hwidvorakinfo/BeastH7_v1/BEASTH7_01.pdf

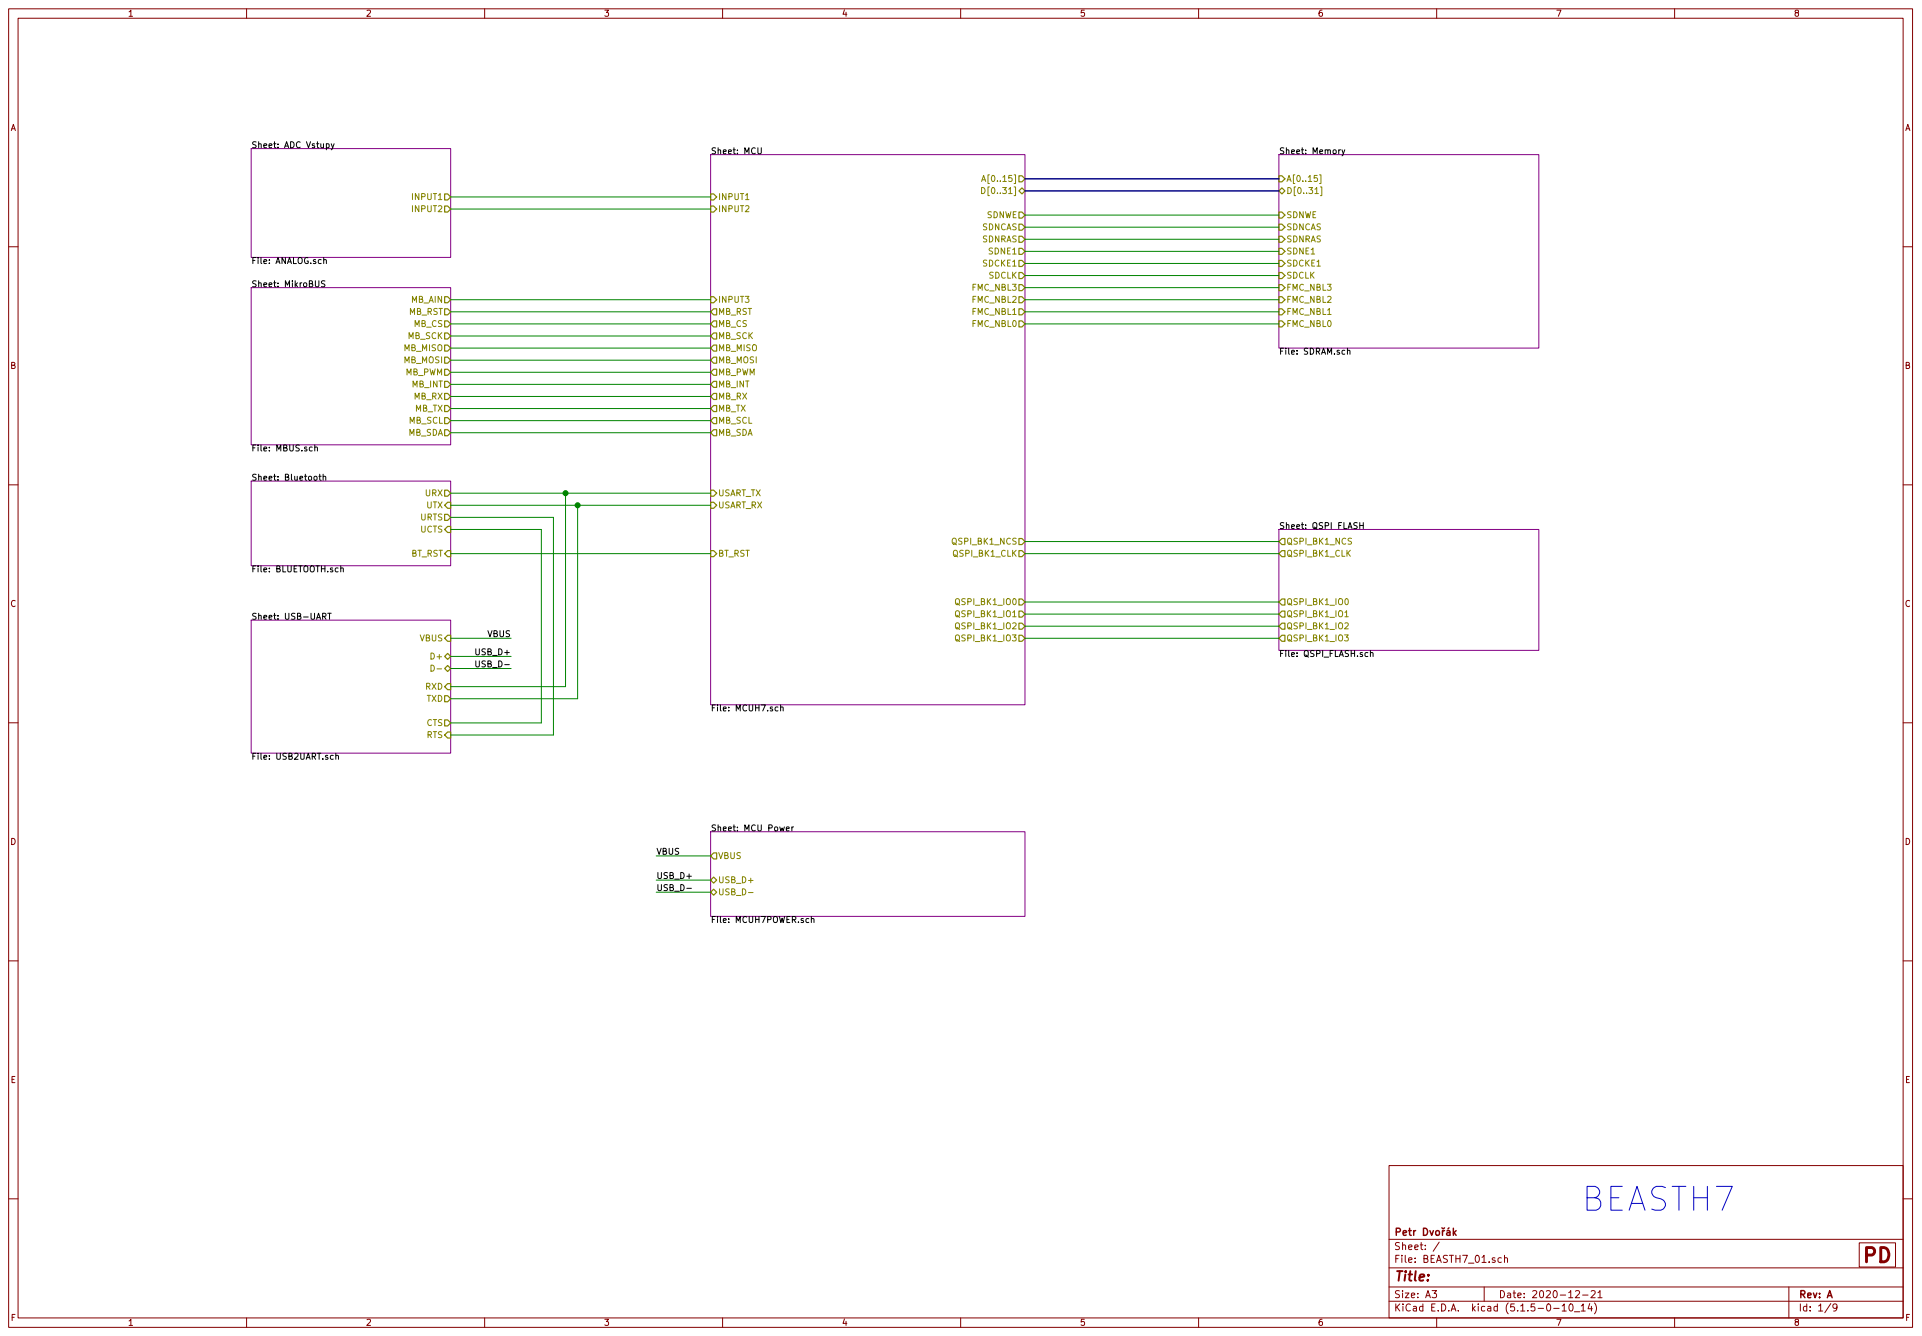
[picture p1: page 1]

Sheet: ADC Vstupy File: ANALOG.sch

Sheet: Memory File: SDRAM.sch A[0..15]

FMC_NBL3 FMC_NBL2 FMC_NBL1 FMC_NBL0 Sheet: MCU Power File: MCUH7POWER.sch USB_D+ USB_D- VBUS
INPUT3 USART_TX USART_RX MB_RST MB_CS MB_SCK MB_MISO MB_MOSI MB_PWM

File: BEASTH7_01.sch Sheet: / Petr Dvoák

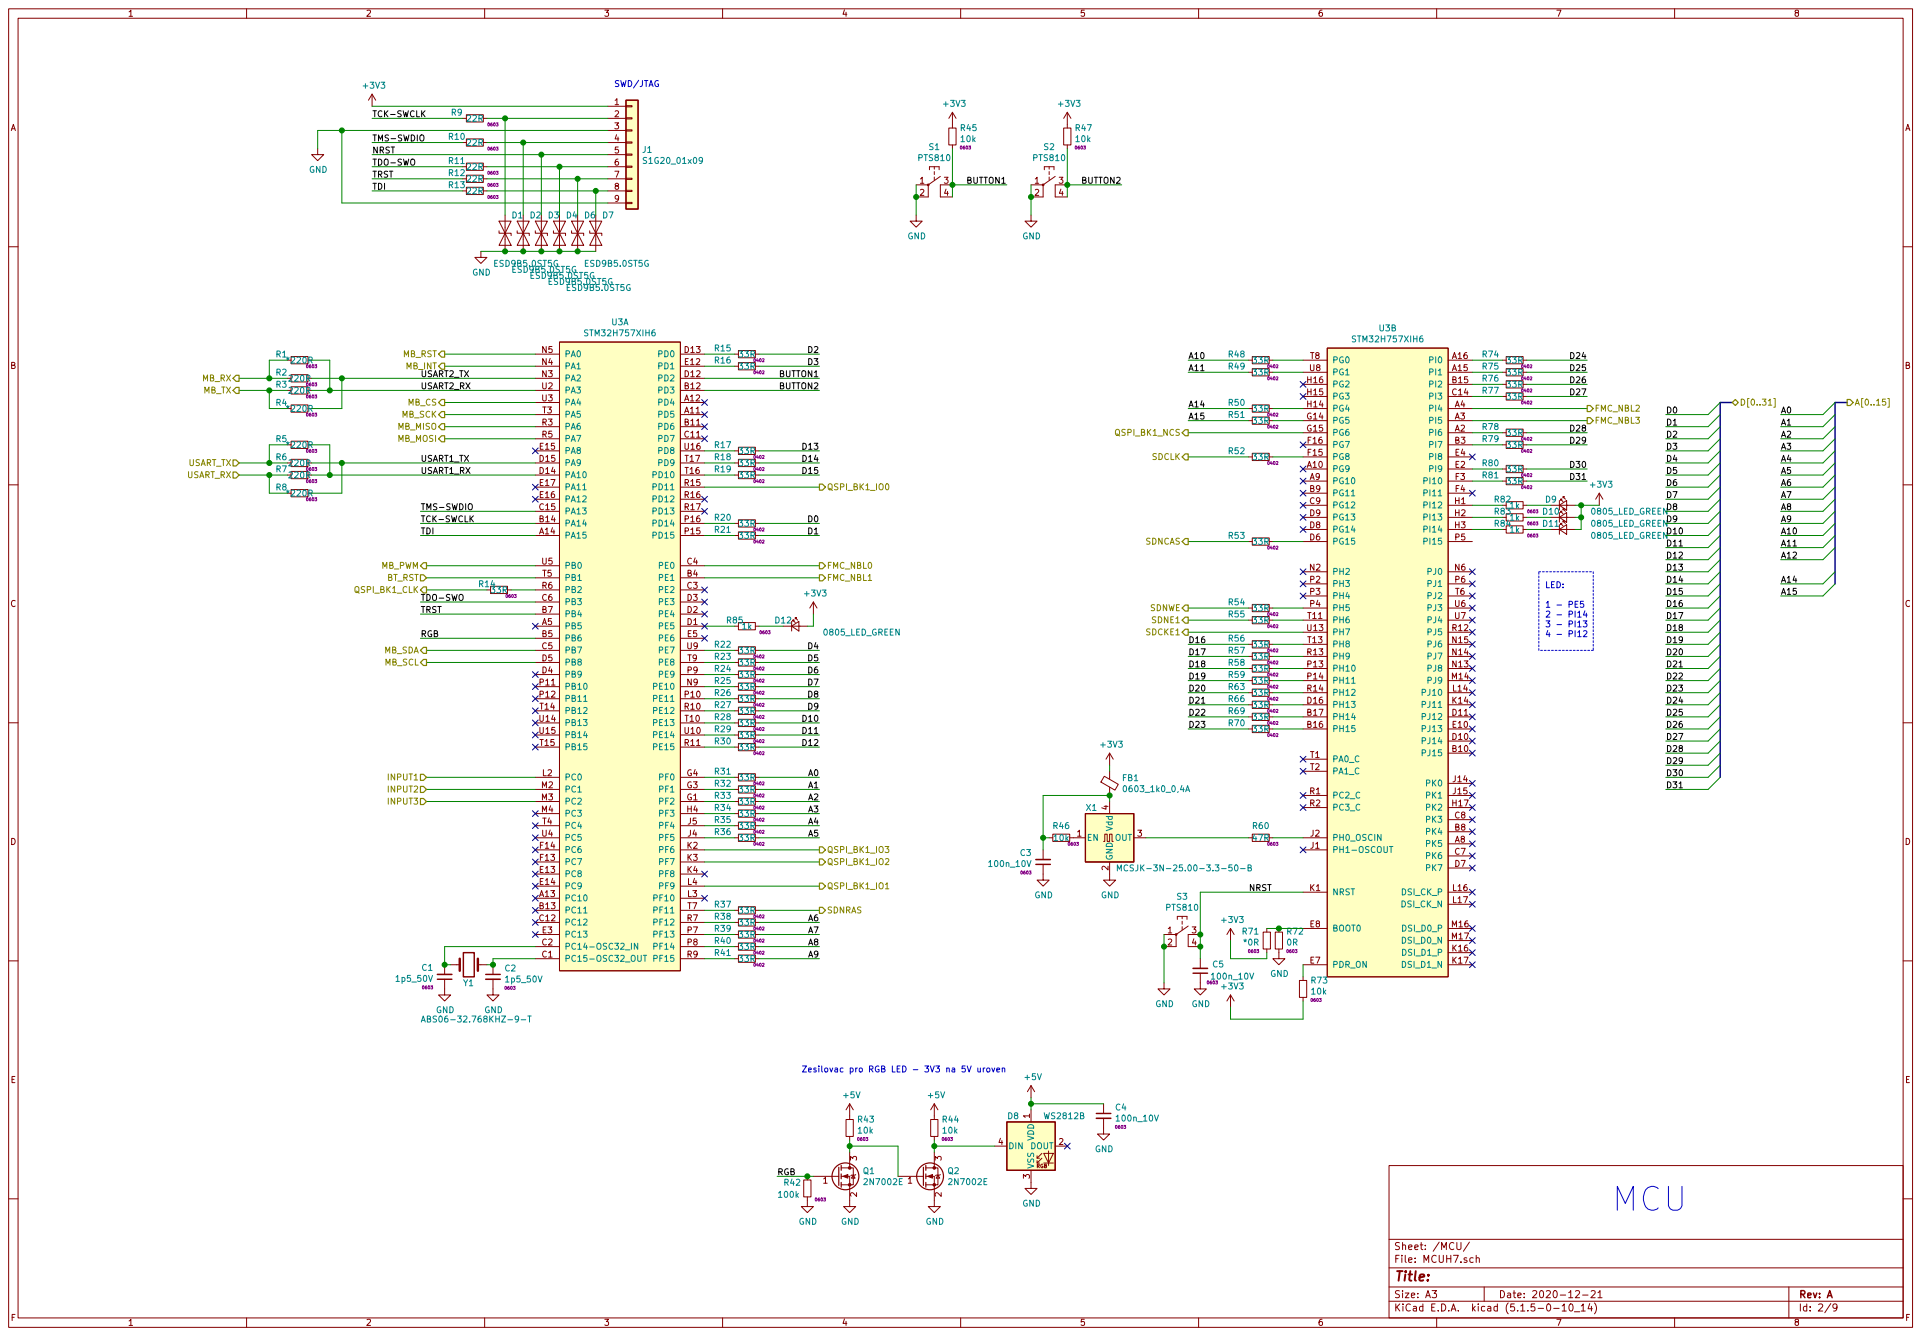
[picture p2: page 2]

6 | J1S1G20_01x09 GND

2 OUT 3 Vdd X1 4 MCSJK-3N-25.00-3.3-50-B GND

Zesilovac pro RGB LED - 3V3 na 5V uroven

Id: 2/9 Title: File: MCUH7.sch Sheet: /MCU/

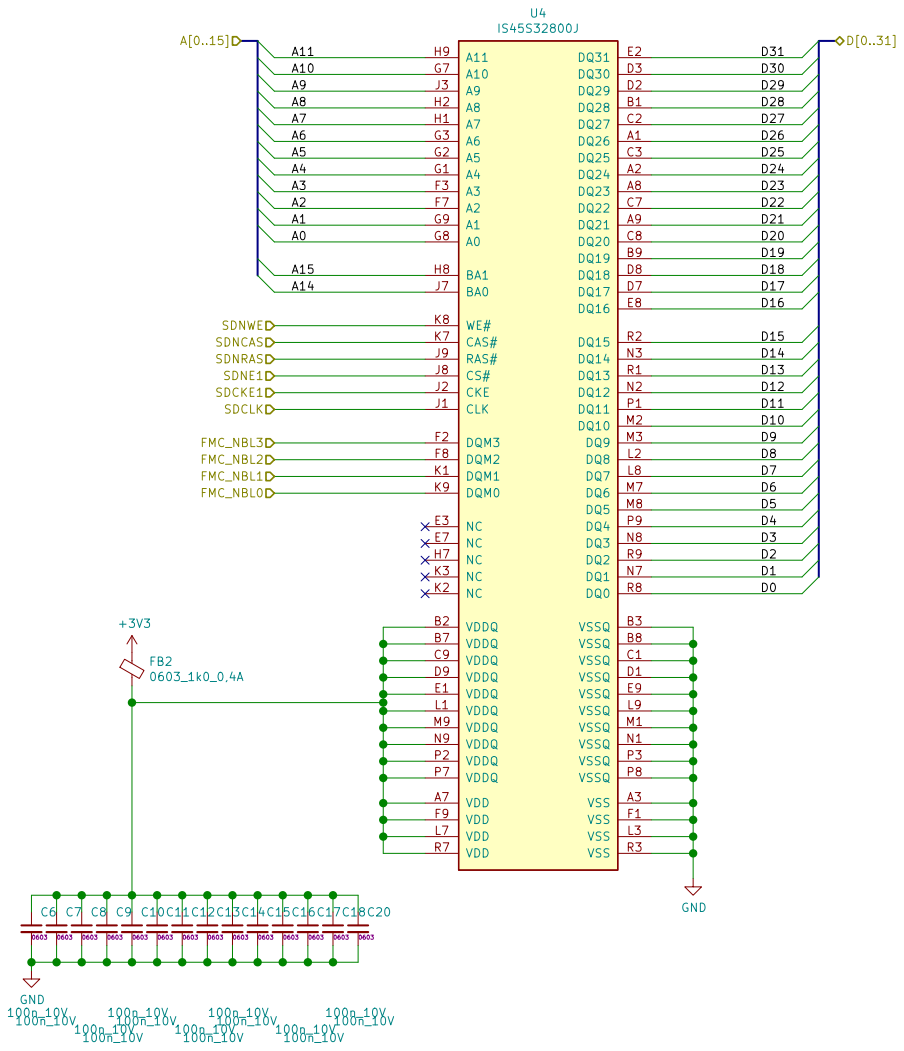
[picture p3: page 3]

Id: 3/9 Title: File: SDRAM.sch Sheet: /Memory/

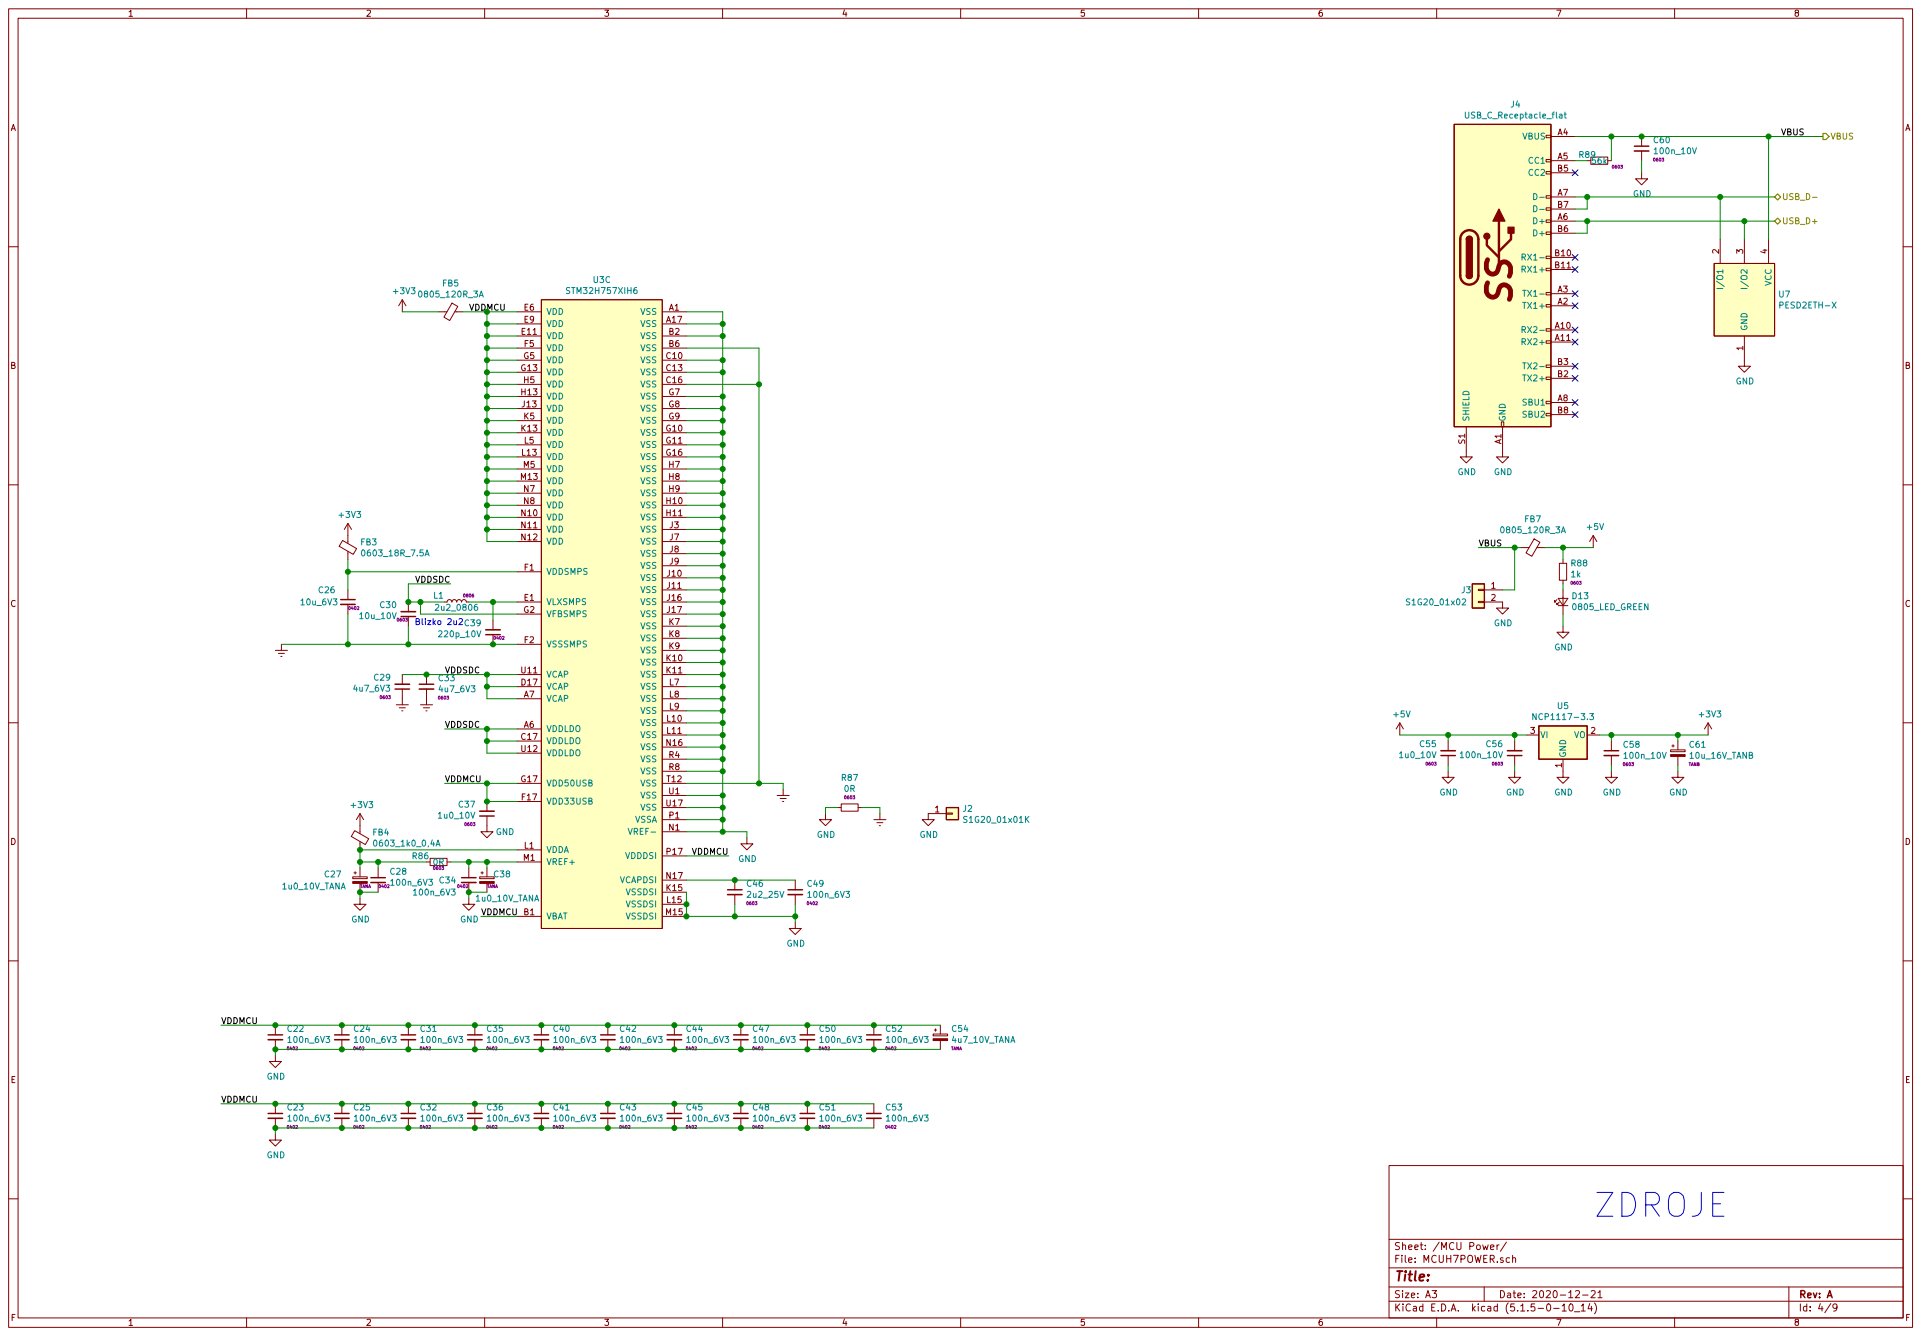
[picture p4: page 4]

Id: 4/9 Title: File: MCUH7POWER.sch Sheet: /MCU Power/

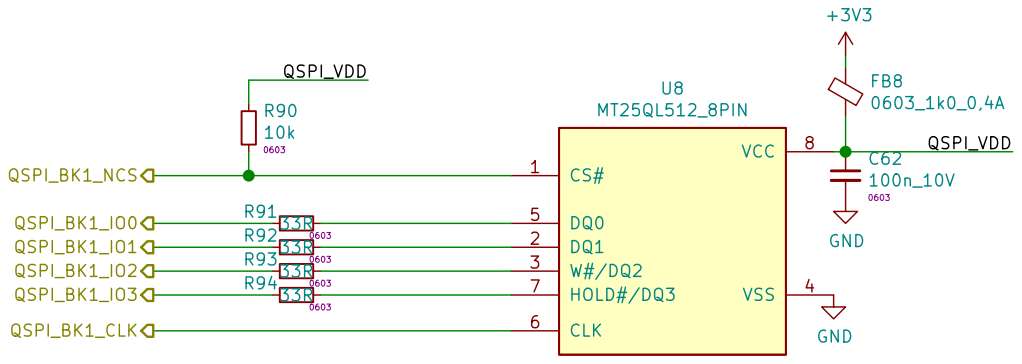
[picture p5: page 5]

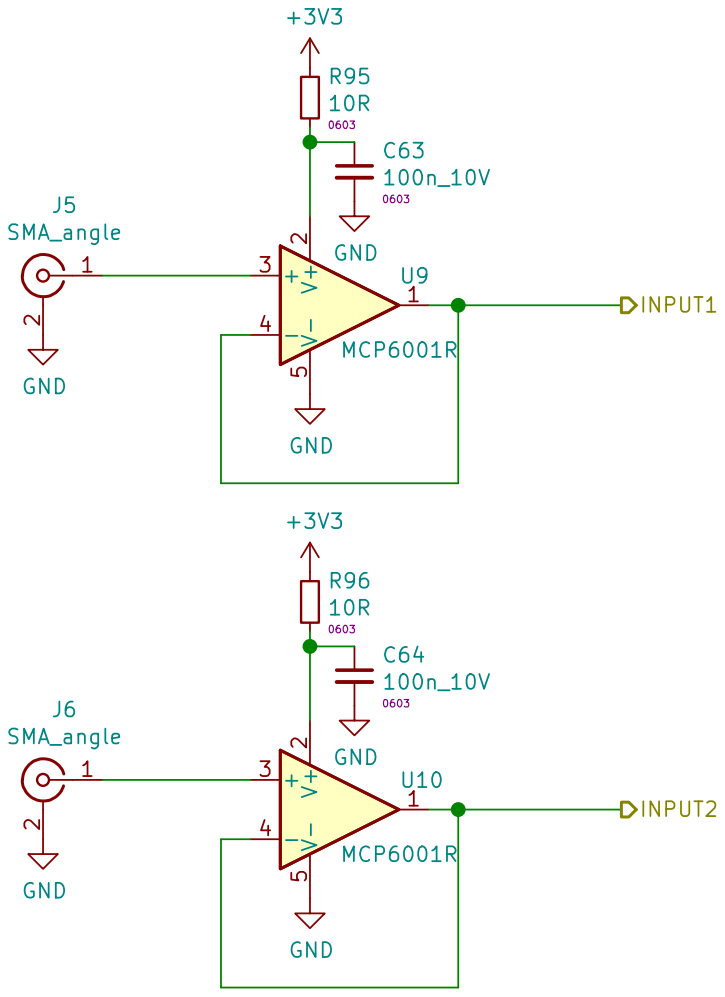
[picture p6: page 6]

Id: 6/9 Title: File: ANALOG.sch Sheet: /ADC Vstupy/ V+

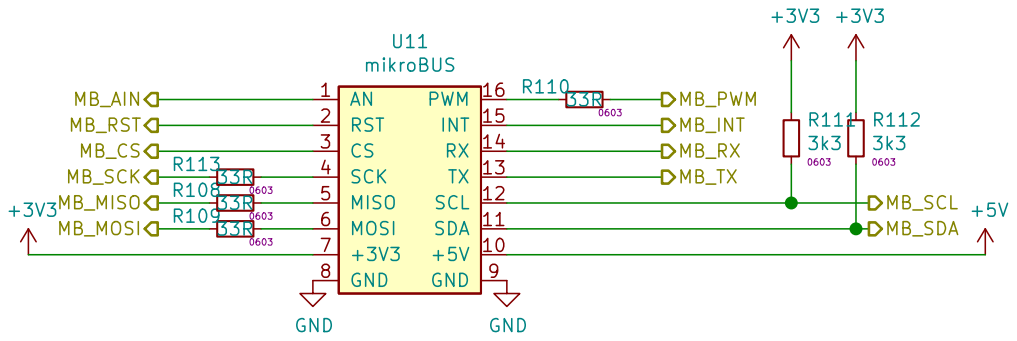
[picture p7: page 7]

Id: 7/9 Title: File: MBUS.sch Sheet: /MikroBUS/

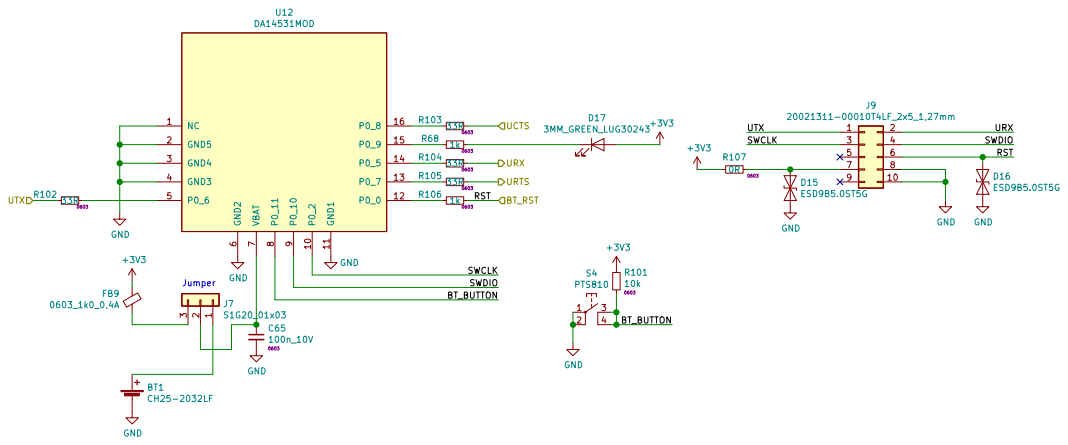
[picture p8: page 8]

Id: 8/9 Title: File: BLUETOOTH.sch Sheet: /Bluetooth/

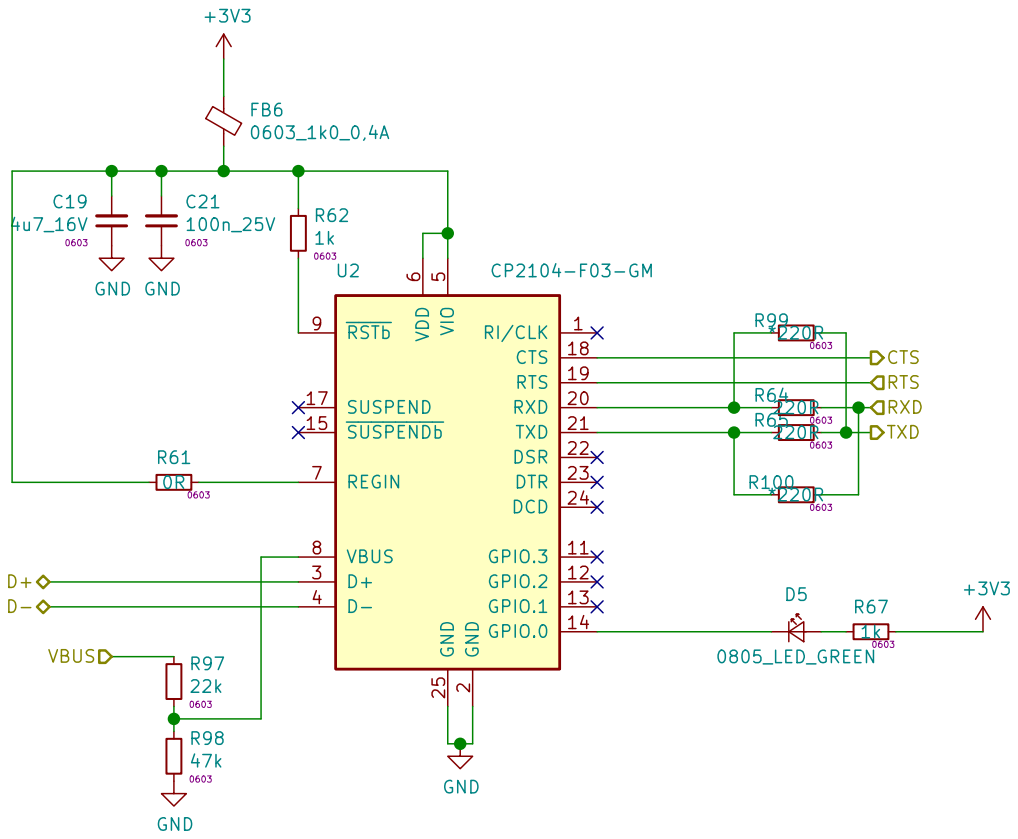
[picture p9: page 9]

6 REGIN 7 VBUS 8 RSTb 9 U2 CP2104-F03-GM

2 RXD 20 TXD 21 DSR 22 DTR 23 DCD 24 GND 25 D+ 3 D- 4 VIO

Id: 9/9 Title: File: USB2UART.sch Sheet: /USB-UART/ GND
