hwidvorakinfo/BeastH7_v1/BEASTH7_01.kicad_pcb

## KiCad design BEASTH7_01.kicad_pcb (2021-05-04)

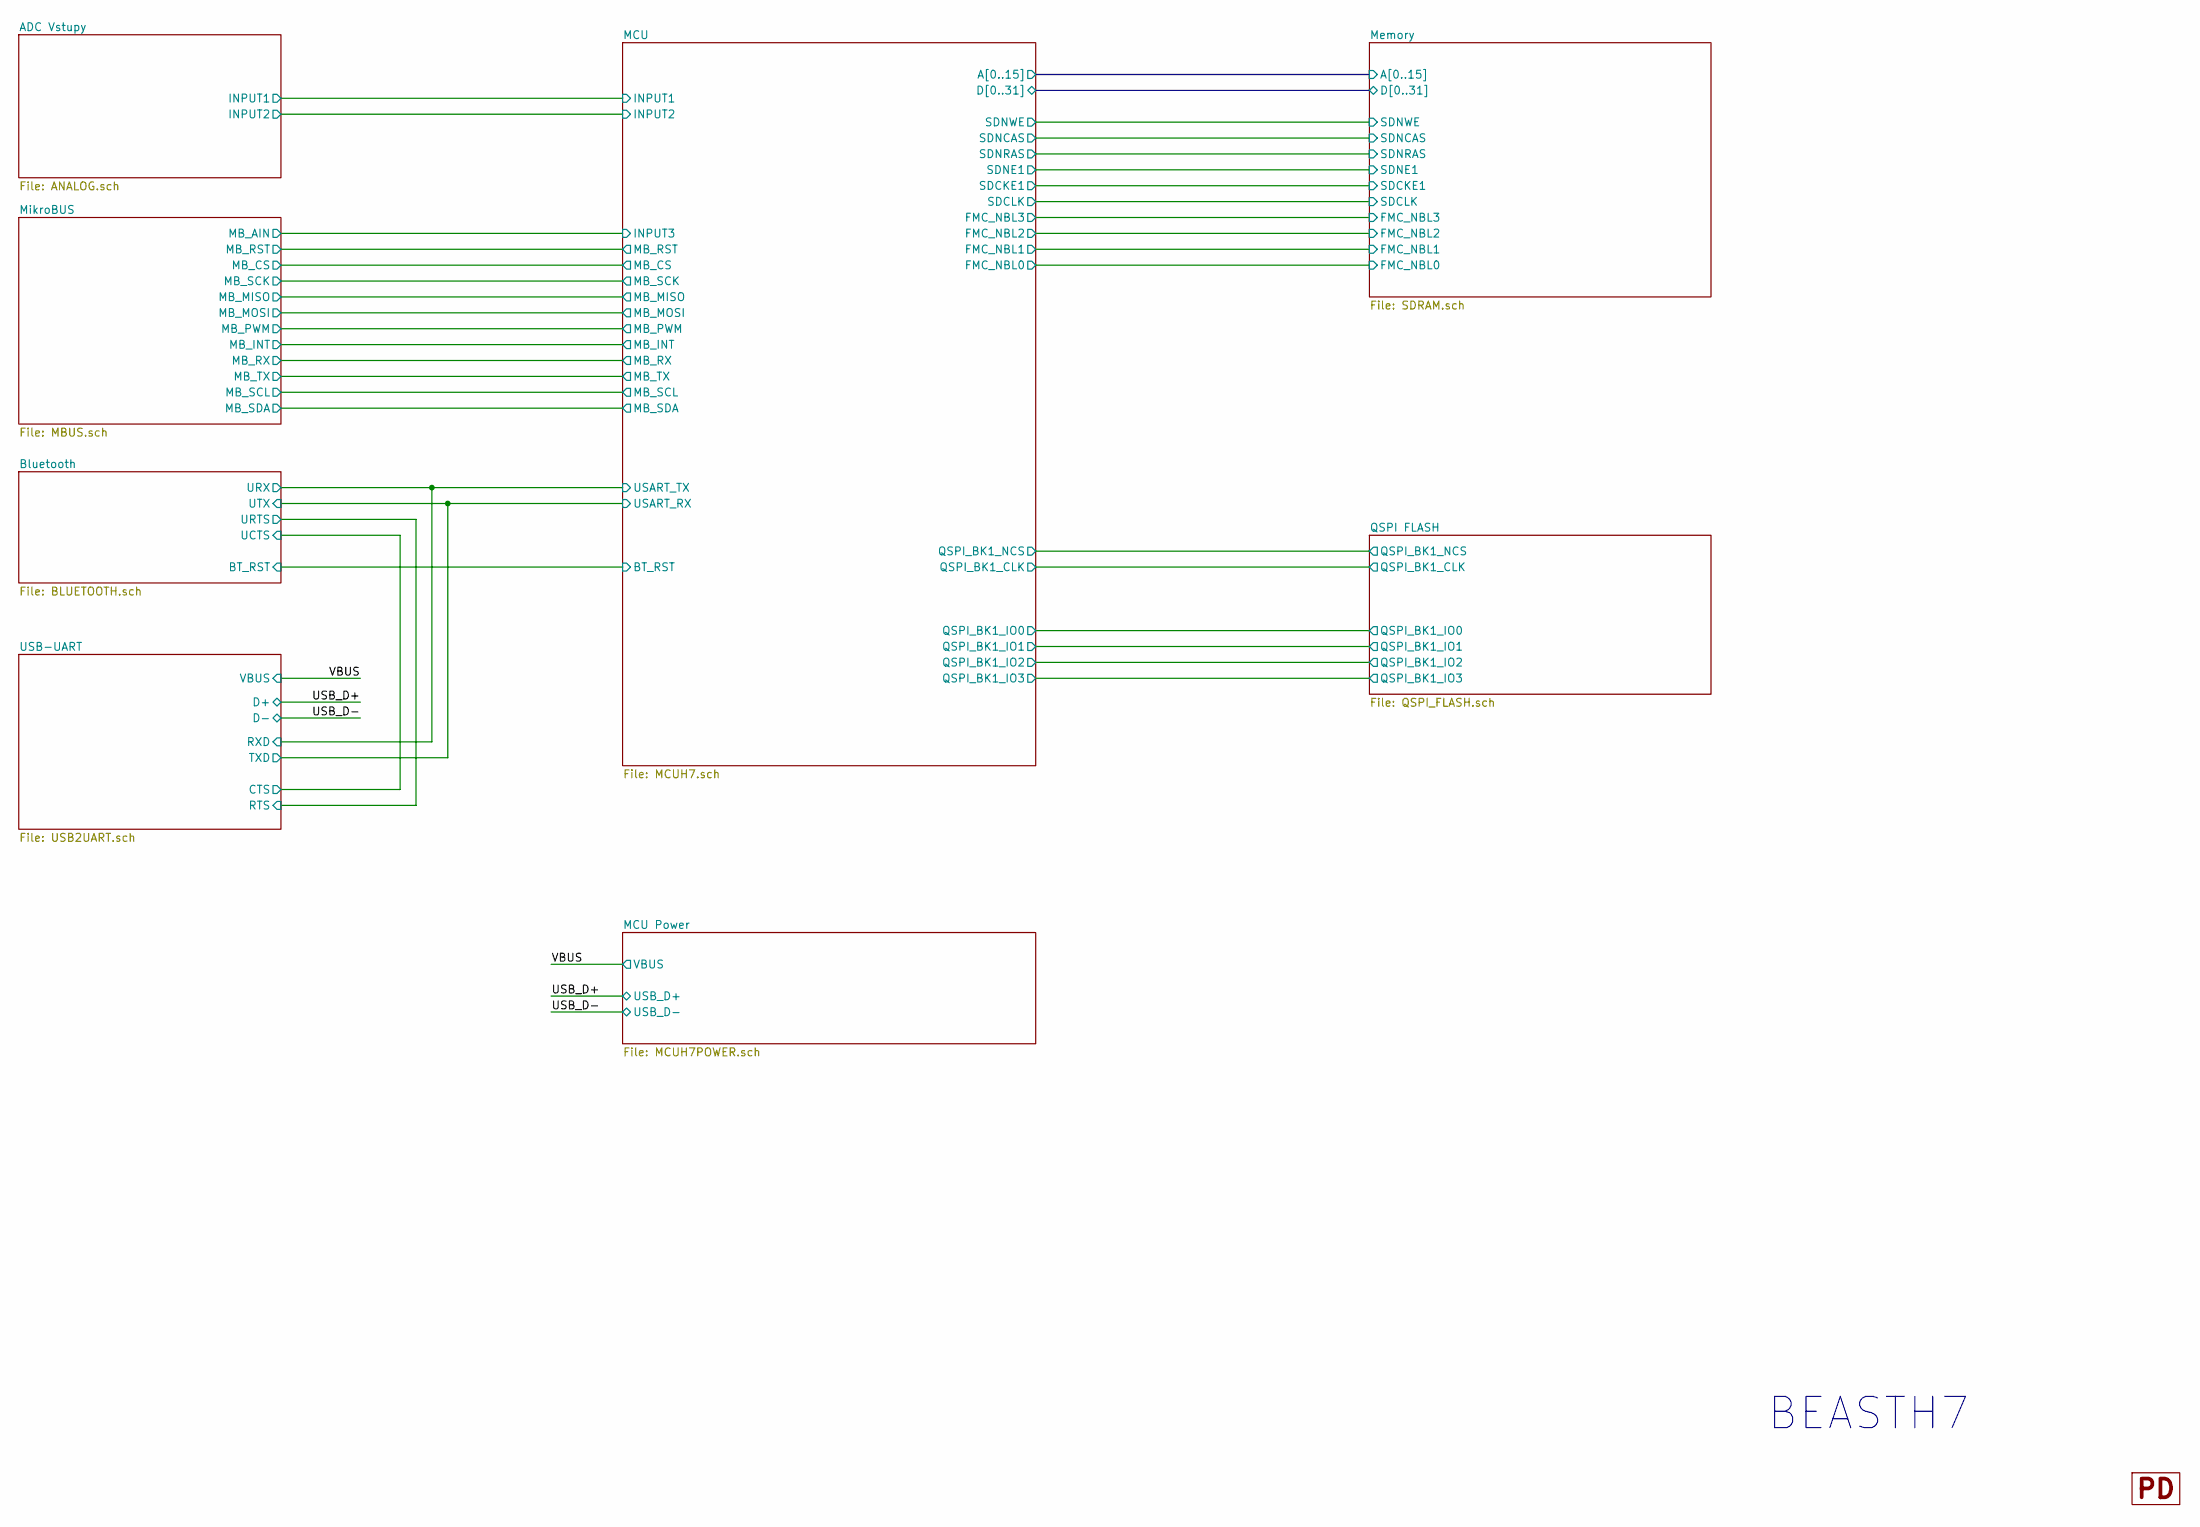
[picture p10: schematic BEASTH7_01.sch]

Parts:
U1: LOGO_IDVORAK; logo_idvorak_silk_top_5mm

Notes on the sheet:
BEASTH7

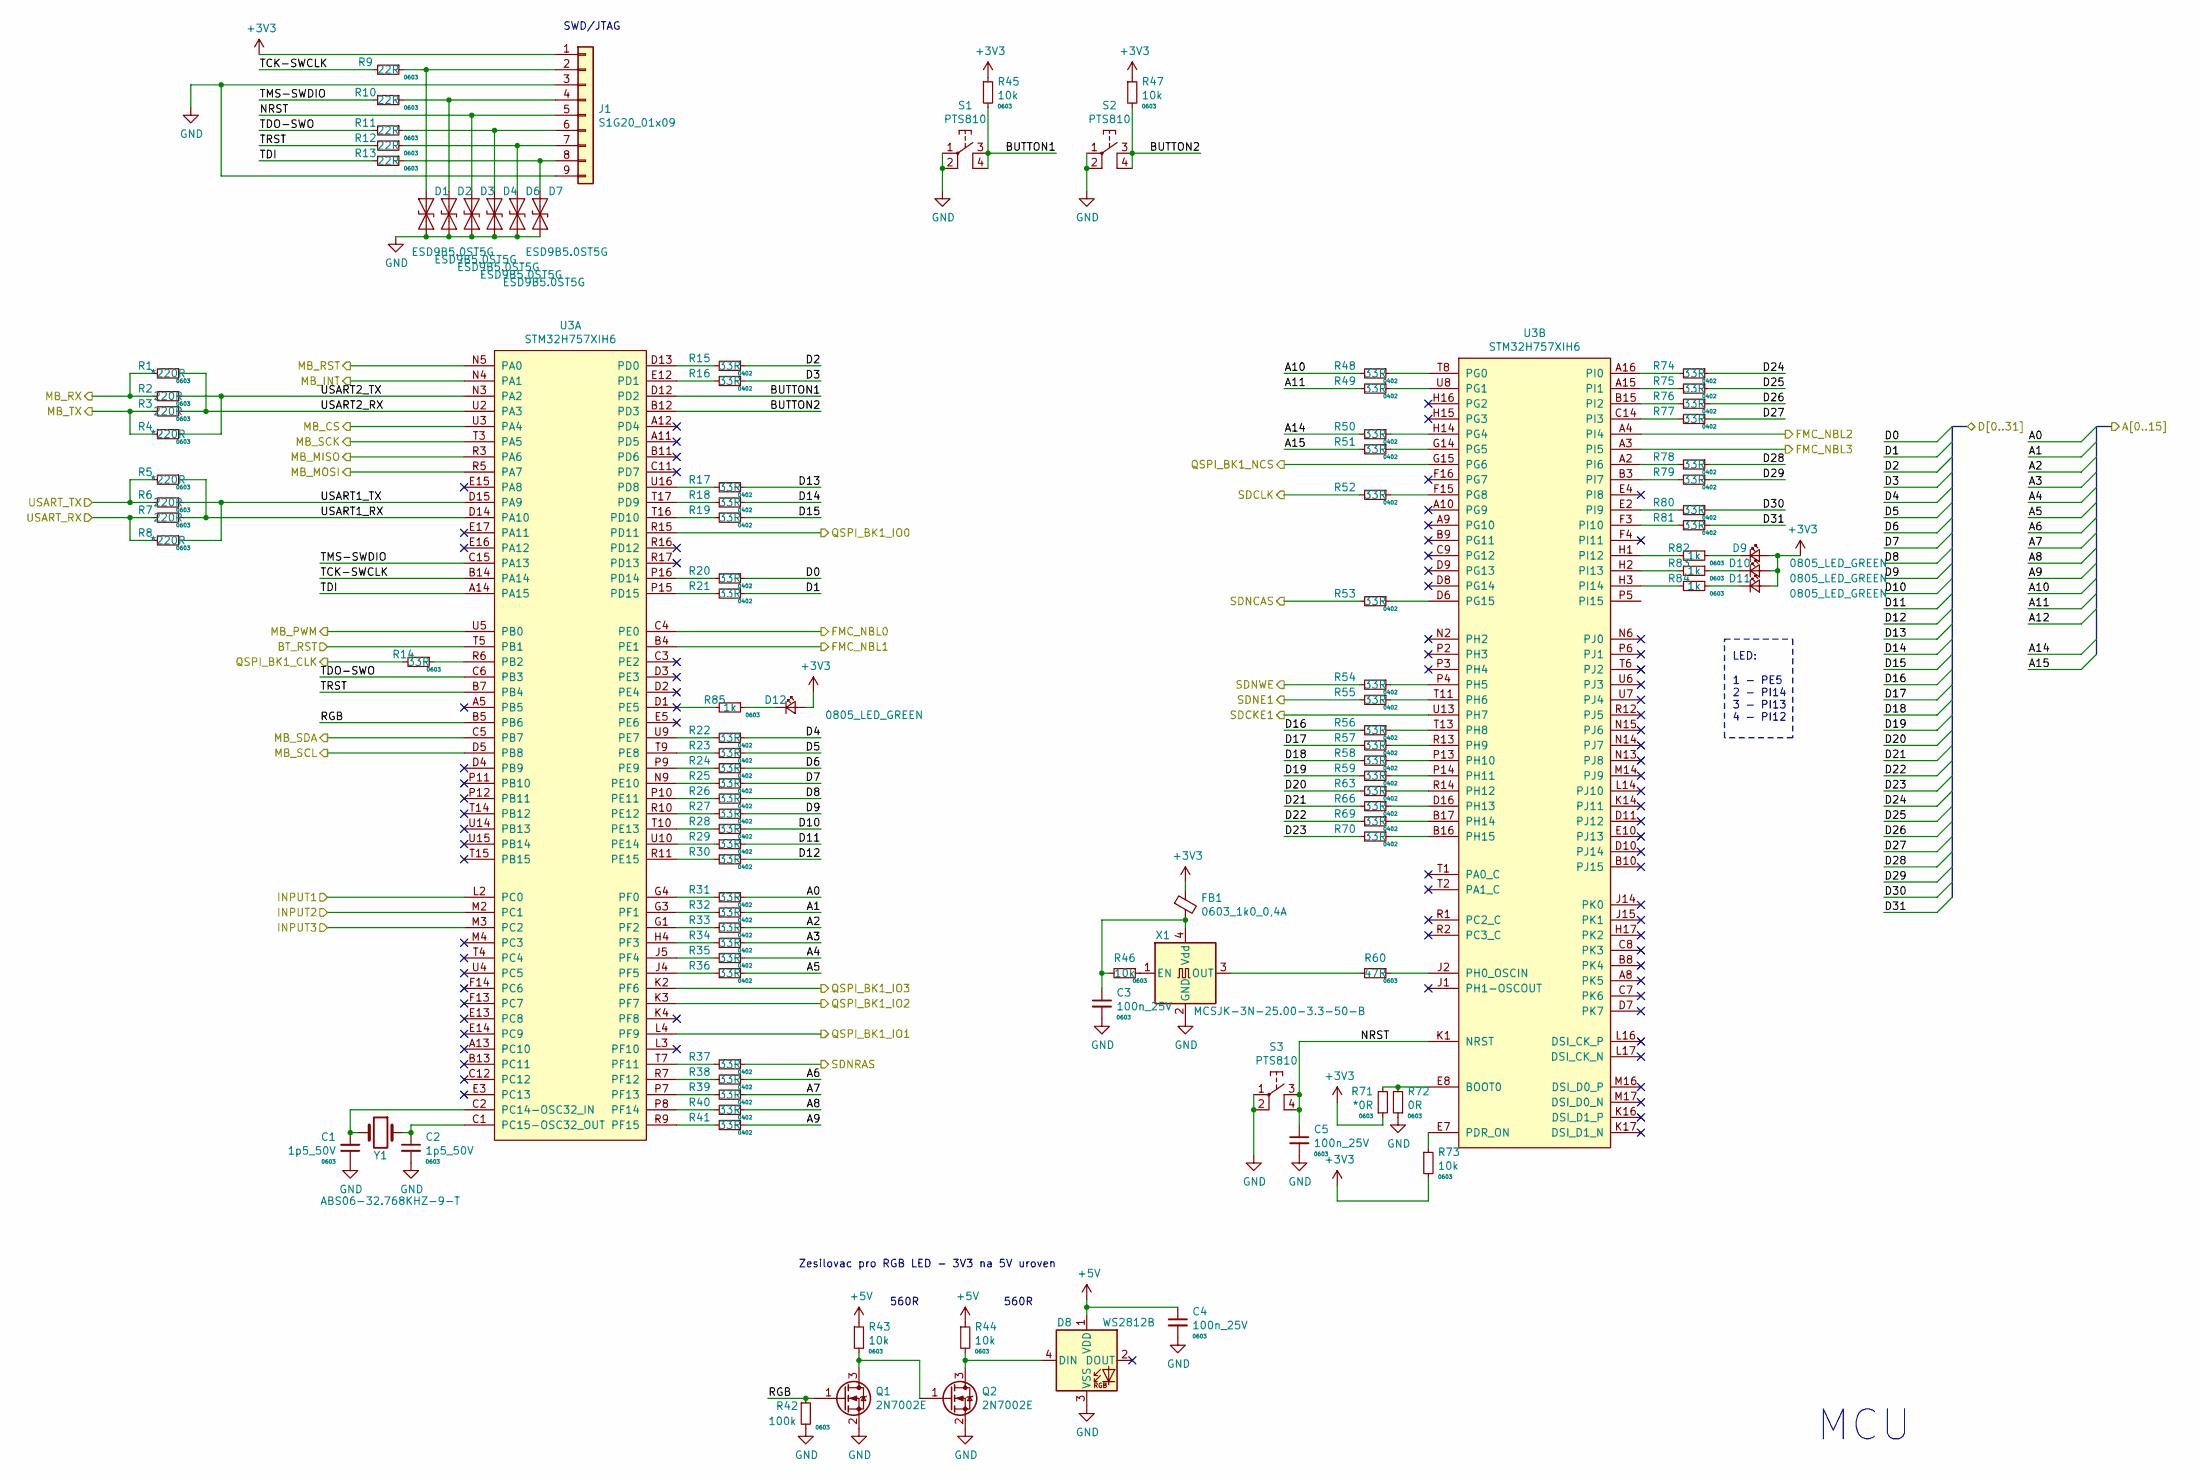
[picture p11: schematic MCUH7.sch]

Parts:
C1, C2: 1p5_50V; C_0603_1608Metric
C3, C4, C5: 100n_25V; C_0603_1608Metric
D1, D2, D3, D4, D6, D7: ESD9B5.0ST5G; D_0402_1005Metric
D8: WS2812B; WS2812B_PLCC4_5.0x5.0mm_P3.2mm
D9, D10, D11, D12: 0805_LED_GREEN; D_0805_2012Metric
FB1: 0603_1k0_0,4A; R_0603_1608Metric
J1: S1G20_01x09; PinHeader_1x09_P2.54mm_Vertical
Q1, Q2: 2N7002E; SOT-23
R1, R4, R5, R8: *220R; R_0603_1608Metric
R2, R3, R6, R7: 220R; R_0603_1608Metric
R9, R10, R11, R12, R13: 22R; R_0603_1608Metric
R14: 33R; R_0603_1608Metric
R15, R16, R17, R18, R19, R20, R21, R22, R23, R24, R25, R26, R27, R28, R29, R30, R31, R32, R33, R34, R35, R36, R37, R38, R39, R40, R41, R48, R49, R50, R51, R52, R53, R54, R55, R56, R57, R58, R59, R63, R66, R69, R70, R74, R75, R76, R77, R78, R79, R80, R81: 33R; R_0402_1005Metric
R42: 100k; R_0603_1608Metric
R43, R44, R45, R46, R47, R73: 10k; R_0603_1608Metric
R60: 47R; R_0603_1608Metric
R71: *0R; R_0603_1608Metric
R72: 0R; R_0603_1608Metric
R82, R83, R84, R85: 1k; R_0603_1608Metric
S1, S2, S3: PTS810; MIKROSPINAC_PTS810
U3: STM32H757XIH6; TFBGA-265_14x14mm_Layout17x17_P0.8mm
X1: MCSJK-3N-25.00-3.3-50-B; Oscillator_SMD_Abracon_ASE-4Pin_3.2x2.5mm
Y1: ABS06-32.768KHZ-9-T; Crystal_SMD_2012-2Pin_2.0x1.2mm_HandSoldering

Connections:
+3V3: D9.2 (A), D10.2 (A), D11.2 (A), D12.2 (A), FB1.1, J1.1, R45.1, R47.1, R71.1, R73.2; also elsewhere on the board
+5V: C4.1, D8.1 (VDD), R43.1, R44.1; also elsewhere on the board
/ADC Vstupy/INPUT1: U3.L2 (PC0); also elsewhere on the board
/ADC Vstupy/INPUT2: U3.M2 (PC1); also elsewhere on the board
/Bluetooth/BT_RST: U3.T5 (PB1); also elsewhere on the board
/MCU/A0: R31.1; also elsewhere on the board
/MCU/A1: R32.1; also elsewhere on the board
/MCU/A2: R33.1; also elsewhere on the board
/MCU/A3: R34.1; also elsewhere on the board
/MCU/A4: R35.1; also elsewhere on the board
/MCU/A5: R36.1; also elsewhere on the board
/MCU/A6: R38.1; also elsewhere on the board
/MCU/A7: R39.1; also elsewhere on the board
/MCU/A8: R40.1; also elsewhere on the board
/MCU/A9: R41.1; also elsewhere on the board
/MCU/A10: R48.2; also elsewhere on the board
/MCU/A11: R49.2; also elsewhere on the board
/MCU/A14: R50.2; also elsewhere on the board
/MCU/A15: R51.2; also elsewhere on the board
/MCU/BUTTON1: R45.2, S1.3, S1.4, U3.D12 (PD2)
/MCU/BUTTON2: R47.2, S2.3, S2.4, U3.B12 (PD3)
/MCU/D0: R20.1; also elsewhere on the board
/MCU/D1: R21.1; also elsewhere on the board
/MCU/D2: R15.1; also elsewhere on the board
/MCU/D3: R16.1; also elsewhere on the board
/MCU/D4: R22.1; also elsewhere on the board
/MCU/D5: R23.1; also elsewhere on the board
/MCU/D6: R24.1; also elsewhere on the board
/MCU/D7: R25.1; also elsewhere on the board
/MCU/D8: R26.1; also elsewhere on the board
/MCU/D9: R27.1; also elsewhere on the board
/MCU/D10: R28.1; also elsewhere on the board
/MCU/D11: R29.1; also elsewhere on the board
/MCU/D12: R30.1; also elsewhere on the board
/MCU/D13: R17.1; also elsewhere on the board
/MCU/D14: R18.1; also elsewhere on the board
/MCU/D15: R19.1; also elsewhere on the board
/MCU/D16: R56.2; also elsewhere on the board
/MCU/D17: R57.2; also elsewhere on the board
/MCU/D18: R58.2; also elsewhere on the board
/MCU/D19: R59.2; also elsewhere on the board
/MCU/D20: R63.2; also elsewhere on the board
/MCU/D21: R66.2; also elsewhere on the board
/MCU/D22: R69.2; also elsewhere on the board
/MCU/D23: R70.2; also elsewhere on the board
/MCU/D24: R74.1; also elsewhere on the board
/MCU/D25: R75.1; also elsewhere on the board
/MCU/D26: R76.1; also elsewhere on the board
/MCU/D27: R77.1; also elsewhere on the board
/MCU/D28: R78.1; also elsewhere on the board
/MCU/D29: R79.1; also elsewhere on the board
/MCU/D30: R80.1; also elsewhere on the board
/MCU/D31: R81.1; also elsewhere on the board
/MCU/FMC_NBL0: U3.C4 (PE0); also elsewhere on the board
/MCU/FMC_NBL1: U3.B4 (PE1); also elsewhere on the board
/MCU/FMC_NBL2: U3.A4 (PI4); also elsewhere on the board
/MCU/FMC_NBL3: U3.A3 (PI5); also elsewhere on the board
/MCU/INPUT3: U3.M3 (PC2); also elsewhere on the board
/MCU/MB_CS: U3.U3 (PA4); also elsewhere on the board
/MCU/MB_INT: U3.N4 (PA1); also elsewhere on the board
/MCU/MB_MISO: U3.R3 (PA6); also elsewhere on the board
/MCU/MB_MOSI: U3.R5 (PA7); also elsewhere on the board
/MCU/MB_PWM: U3.U5 (PB0); also elsewhere on the board
/MCU/MB_RST: U3.N5 (PA0); also elsewhere on the board
/MCU/MB_RX: R1.2, R2.2; also elsewhere on the board
/MCU/MB_SCK: U3.T3 (PA5); also elsewhere on the board
/MCU/MB_SCL: U3.D5 (PB8); also elsewhere on the board
/MCU/MB_SDA: U3.C5 (PB7); also elsewhere on the board
/MCU/MB_TX: R3.2, R4.2; also elsewhere on the board
/MCU/NRST: C5.1, D3.1 (A1), J1.5, S3.3, S3.4, U3.K1 (NRST)
/MCU/QSPI_BK1_CLK: R14.2; also elsewhere on the board
/MCU/QSPI_BK1_IO0: U3.R15 (PD11); also elsewhere on the board
/MCU/QSPI_BK1_IO1: U3.L4 (PF9); also elsewhere on the board
/MCU/QSPI_BK1_IO2: U3.K3 (PF7); also elsewhere on the board
/MCU/QSPI_BK1_IO3: U3.K2 (PF6); also elsewhere on the board
/MCU/QSPI_BK1_NCS: U3.G15 (PG6); also elsewhere on the board
/MCU/RGB: Q1.1 (G), R42.1, U3.B5 (PB6)
/MCU/SDCKE1: U3.U13 (PH7); also elsewhere on the board
/MCU/SDCLK: R52.2; also elsewhere on the board
/MCU/SDNCAS: R53.2; also elsewhere on the board
/MCU/SDNE1: R55.2; also elsewhere on the board
/MCU/SDNRAS: R37.1; also elsewhere on the board
/MCU/SDNWE: R54.2; also elsewhere on the board
/MCU/TCK-SWCLK: R9.2, U3.B14 (PA14)
/MCU/TDI: R13.2, U3.A14 (PA15)
/MCU/TDO-SWO: R11.2, U3.C6 (PB3)
/MCU/TMS-SWDIO: R10.2, U3.C15 (PA13)
/MCU/TRST: R12.2, U3.B7 (PB4)
/MCU/USART1_RX: R5.1, R7.1, U3.D14 (PA10)
/MCU/USART1_TX: R6.1, R8.1, U3.D15 (PA9)
/MCU/USART2_RX: R1.1, R3.1, U3.U2 (PA3)
/MCU/USART2_TX: R2.1, R4.1, U3.N3 (PA2)
/USB-UART/RXD: R5.2, R6.2; also elsewhere on the board
/USB-UART/TXD: R7.2, R8.2; also elsewhere on the board
GND: C1.1, C2.2, C3.2, C4.2, C5.2, D1.2 (A2), D2.2 (A2), D3.2 (A2), D4.2 (A2), D6.2 (A2), D7.2 (A2), D8.3 (VSS), J1.3, J1.9, Q1.2 (S), Q2.2 (S), R42.2, R72.1, S1.1, S1.2, S2.1, S2.2, S3.1, S3.2, X1.2 (GND); also elsewhere on the board
unnamed: C1.2, U3.C2 (PC14-OSC32_IN), Y1.2
unnamed: C2.1, U3.C1 (PC15-OSC32_OUT), Y1.1
unnamed: C3.1, FB1.2, R46.2, X1.4 (Vdd)
unnamed: D1.1 (A1), J1.2, R9.1
unnamed: D2.1 (A1), J1.4, R10.1
unnamed: D4.1 (A1), J1.6, R11.1
unnamed: D6.1 (A1), J1.7, R12.1
unnamed: D7.1 (A1), J1.8, R13.1
unnamed: D8.4 (DIN), Q2.3 (D), R44.2
unnamed: D9.1 (K), R82.1
unnamed: D10.1 (K), R83.1
unnamed: D11.1 (K), R84.1
unnamed: D12.1 (K), R85.1
unnamed: Q1.3 (D), Q2.1 (G), R43.2
unnamed: R14.1, U3.R6 (PB2)
unnamed: R15.2, U3.D13 (PD0)
unnamed: R16.2, U3.E12 (PD1)
unnamed: R17.2, U3.U16 (PD8)
unnamed: R18.2, U3.T17 (PD9)
unnamed: R19.2, U3.T16 (PD10)
unnamed: R20.2, U3.P16 (PD14)
unnamed: R21.2, U3.P15 (PD15)
unnamed: R22.2, U3.U9 (PE7)
unnamed: R23.2, U3.T9 (PE8)
unnamed: R24.2, U3.P9 (PE9)
unnamed: R25.2, U3.N9 (PE10)
unnamed: R26.2, U3.P10 (PE11)
unnamed: R27.2, U3.R10 (PE12)
unnamed: R28.2, U3.T10 (PE13)
unnamed: R29.2, U3.U10 (PE14)
unnamed: R30.2, U3.R11 (PE15)
unnamed: R31.2, U3.G4 (PF0)
unnamed: R32.2, U3.G3 (PF1)
unnamed: R33.2, U3.G1 (PF2)
unnamed: R34.2, U3.H4 (PF3)
unnamed: R35.2, U3.J5 (PF4)
unnamed: R36.2, U3.J4 (PF5)
unnamed: R37.2, U3.T7 (PF11)
unnamed: R38.2, U3.R7 (PF12)
unnamed: R39.2, U3.P7 (PF13)
unnamed: R40.2, U3.P8 (PF14)
unnamed: R41.2, U3.R9 (PF15)
unnamed: R46.1, X1.1 (EN)
unnamed: R48.1, U3.T8 (PG0)
unnamed: R49.1, U3.U8 (PG1)
unnamed: R50.1, U3.H14 (PG4)
unnamed: R51.1, U3.G14 (PG5)
unnamed: R52.1, U3.F15 (PG8)
unnamed: R53.1, U3.D6 (PG15)
unnamed: R54.1, U3.P4 (PH5)
unnamed: R55.1, U3.T11 (PH6)
unnamed: R56.1, U3.T13 (PH8)
unnamed: R57.1, U3.R13 (PH9)
unnamed: R58.1, U3.P13 (PH10)
unnamed: R59.1, U3.P14 (PH11)
unnamed: R60.1, U3.J2 (PH0_OSCIN)
unnamed: R60.2, X1.3 (OUT)
unnamed: R63.1, U3.R14 (PH12)
unnamed: R66.1, U3.D16 (PH13)
unnamed: R69.1, U3.B17 (PH14)
unnamed: R70.1, U3.B16 (PH15)
unnamed: R71.2, R72.2, U3.E8 (BOOT0)
unnamed: R73.1, U3.E7 (PDR_ON)
unnamed: R74.2, U3.A16 (PI0)
unnamed: R75.2, U3.A15 (PI1)
unnamed: R76.2, U3.B15 (PI2)
unnamed: R77.2, U3.C14 (PI3)
unnamed: R78.2, U3.A2 (PI6)
unnamed: R79.2, U3.B3 (PI7)
unnamed: R80.2, U3.E2 (PI9)
unnamed: R81.2, U3.F3 (PI10)
unnamed: R82.2, U3.H1 (PI12)
unnamed: R83.2, U3.H2 (PI13)
unnamed: R84.2, U3.H3 (PI14)
unnamed: R85.2, U3.D1 (PE5)

Notes on the sheet:
Zesilovac pro RGB LED - 3V3 na 5V uroven
SWD/JTAG
MCU
LED: 1 - PE5 2 - PI14 3 - PI13 4 - PI12
560R

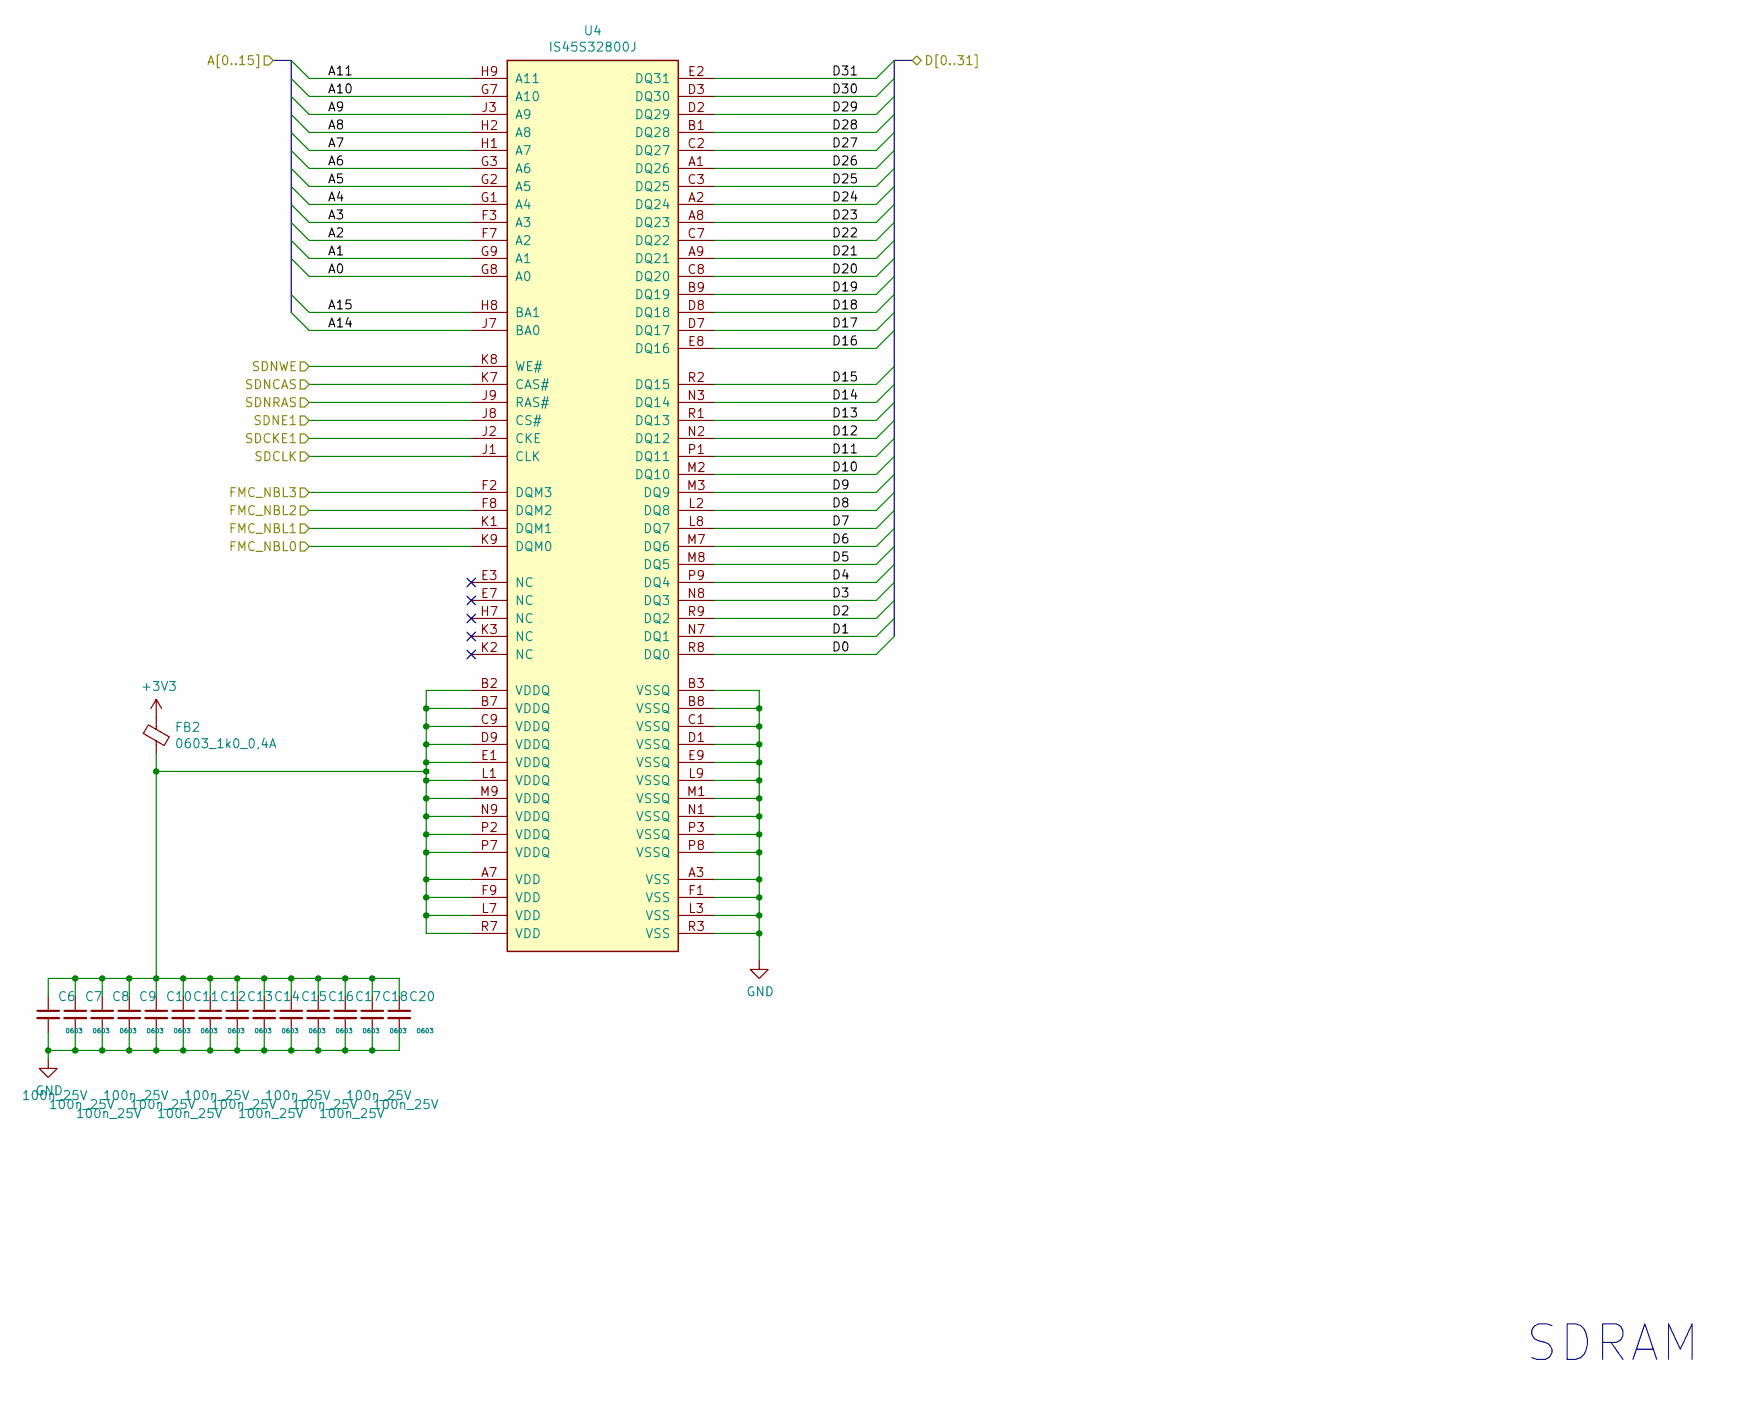
[picture p12: schematic SDRAM.sch]

Parts:
C6, C7, C8, C9, C10, C11, C12, C13, C14, C15, C16, C17, C18, C20: 100n_25V; C_0603_1608Metric
FB2: 0603_1k0_0,4A; R_0603_1608Metric
U4: IS45S32800J; BGA-90_8.0x13.0mm_Layout2x3x15_P0.8mm

Connections:
+3V3: FB2.1; also elsewhere on the board
/MCU/A0: U4.G8 (A0); also elsewhere on the board
/MCU/A1: U4.G9 (A1); also elsewhere on the board
/MCU/A2: U4.F7 (A2); also elsewhere on the board
/MCU/A3: U4.F3 (A3); also elsewhere on the board
/MCU/A4: U4.G1 (A4); also elsewhere on the board
/MCU/A5: U4.G2 (A5); also elsewhere on the board
/MCU/A6: U4.G3 (A6); also elsewhere on the board
/MCU/A7: U4.H1 (A7); also elsewhere on the board
/MCU/A8: U4.H2 (A8); also elsewhere on the board
/MCU/A9: U4.J3 (A9); also elsewhere on the board
/MCU/A10: U4.G7 (A10); also elsewhere on the board
/MCU/A11: U4.H9 (A11); also elsewhere on the board
/MCU/A14: U4.J7 (BA0); also elsewhere on the board
/MCU/A15: U4.H8 (BA1); also elsewhere on the board
/MCU/D0: U4.R8 (DQ0); also elsewhere on the board
/MCU/D1: U4.N7 (DQ1); also elsewhere on the board
/MCU/D2: U4.R9 (DQ2); also elsewhere on the board
/MCU/D3: U4.N8 (DQ3); also elsewhere on the board
/MCU/D4: U4.P9 (DQ4); also elsewhere on the board
/MCU/D5: U4.M8 (DQ5); also elsewhere on the board
/MCU/D6: U4.M7 (DQ6); also elsewhere on the board
/MCU/D7: U4.L8 (DQ7); also elsewhere on the board
/MCU/D8: U4.L2 (DQ8); also elsewhere on the board
/MCU/D9: U4.M3 (DQ9); also elsewhere on the board
/MCU/D10: U4.M2 (DQ10); also elsewhere on the board
/MCU/D11: U4.P1 (DQ11); also elsewhere on the board
/MCU/D12: U4.N2 (DQ12); also elsewhere on the board
/MCU/D13: U4.R1 (DQ13); also elsewhere on the board
/MCU/D14: U4.N3 (DQ14); also elsewhere on the board
/MCU/D15: U4.R2 (DQ15); also elsewhere on the board
/MCU/D16: U4.E8 (DQ16); also elsewhere on the board
/MCU/D17: U4.D7 (DQ17); also elsewhere on the board
/MCU/D18: U4.D8 (DQ18); also elsewhere on the board
/MCU/D19: U4.B9 (DQ19); also elsewhere on the board
/MCU/D20: U4.C8 (DQ20); also elsewhere on the board
/MCU/D21: U4.A9 (DQ21); also elsewhere on the board
/MCU/D22: U4.C7 (DQ22); also elsewhere on the board
/MCU/D23: U4.A8 (DQ23); also elsewhere on the board
/MCU/D24: U4.A2 (DQ24); also elsewhere on the board
/MCU/D25: U4.C3 (DQ25); also elsewhere on the board
/MCU/D26: U4.A1 (DQ26); also elsewhere on the board
/MCU/D27: U4.C2 (DQ27); also elsewhere on the board
/MCU/D28: U4.B1 (DQ28); also elsewhere on the board
/MCU/D29: U4.D2 (DQ29); also elsewhere on the board
/MCU/D30: U4.D3 (DQ30); also elsewhere on the board
/MCU/D31: U4.E2 (DQ31); also elsewhere on the board
/MCU/FMC_NBL0: U4.K9 (DQM0); also elsewhere on the board
/MCU/FMC_NBL1: U4.K1 (DQM1); also elsewhere on the board
/MCU/FMC_NBL2: U4.F8 (DQM2); also elsewhere on the board
/MCU/FMC_NBL3: U4.F2 (DQM3); also elsewhere on the board
/MCU/SDCKE1: U4.J2 (CKE); also elsewhere on the board
/MCU/SDCLK: U4.J1 (CLK); also elsewhere on the board
/MCU/SDNCAS: U4.K7 (CAS#); also elsewhere on the board
/MCU/SDNE1: U4.J8 (CS#); also elsewhere on the board
/MCU/SDNRAS: U4.J9 (RAS#); also elsewhere on the board
/MCU/SDNWE: U4.K8 (WE#); also elsewhere on the board
GND: C6.2, C7.2, C8.2, C9.2, C10.2, C11.2, C12.2, C13.2, C14.2, C15.2, C16.2, C17.2, C18.2, C20.2, U4.A3 (VSS), U4.B3 (VSSQ), U4.B8 (VSSQ), U4.C1 (VSSQ), U4.D1 (VSSQ), U4.E9 (VSSQ), U4.F1 (VSS), U4.L3 (VSS), U4.L9 (VSSQ), U4.M1 (VSSQ), U4.N1 (VSSQ), U4.P3 (VSSQ), U4.P8 (VSSQ), U4.R3 (VSS); also elsewhere on the board
unnamed: C6.1, C7.1, C8.1, C9.1, C10.1, C11.1, C12.1, C13.1, C14.1, C15.1, C16.1, C17.1, C18.1, C20.1, FB2.2, U4.A7 (VDD), U4.B2 (VDDQ), U4.B7 (VDDQ), U4.C9 (VDDQ), U4.D9 (VDDQ), U4.E1 (VDDQ), U4.F9 (VDD), U4.L1 (VDDQ), U4.L7 (VDD), U4.M9 (VDDQ), U4.N9 (VDDQ), U4.P2 (VDDQ), U4.P7 (VDDQ), U4.R7 (VDD)

Notes on the sheet:
SDRAM

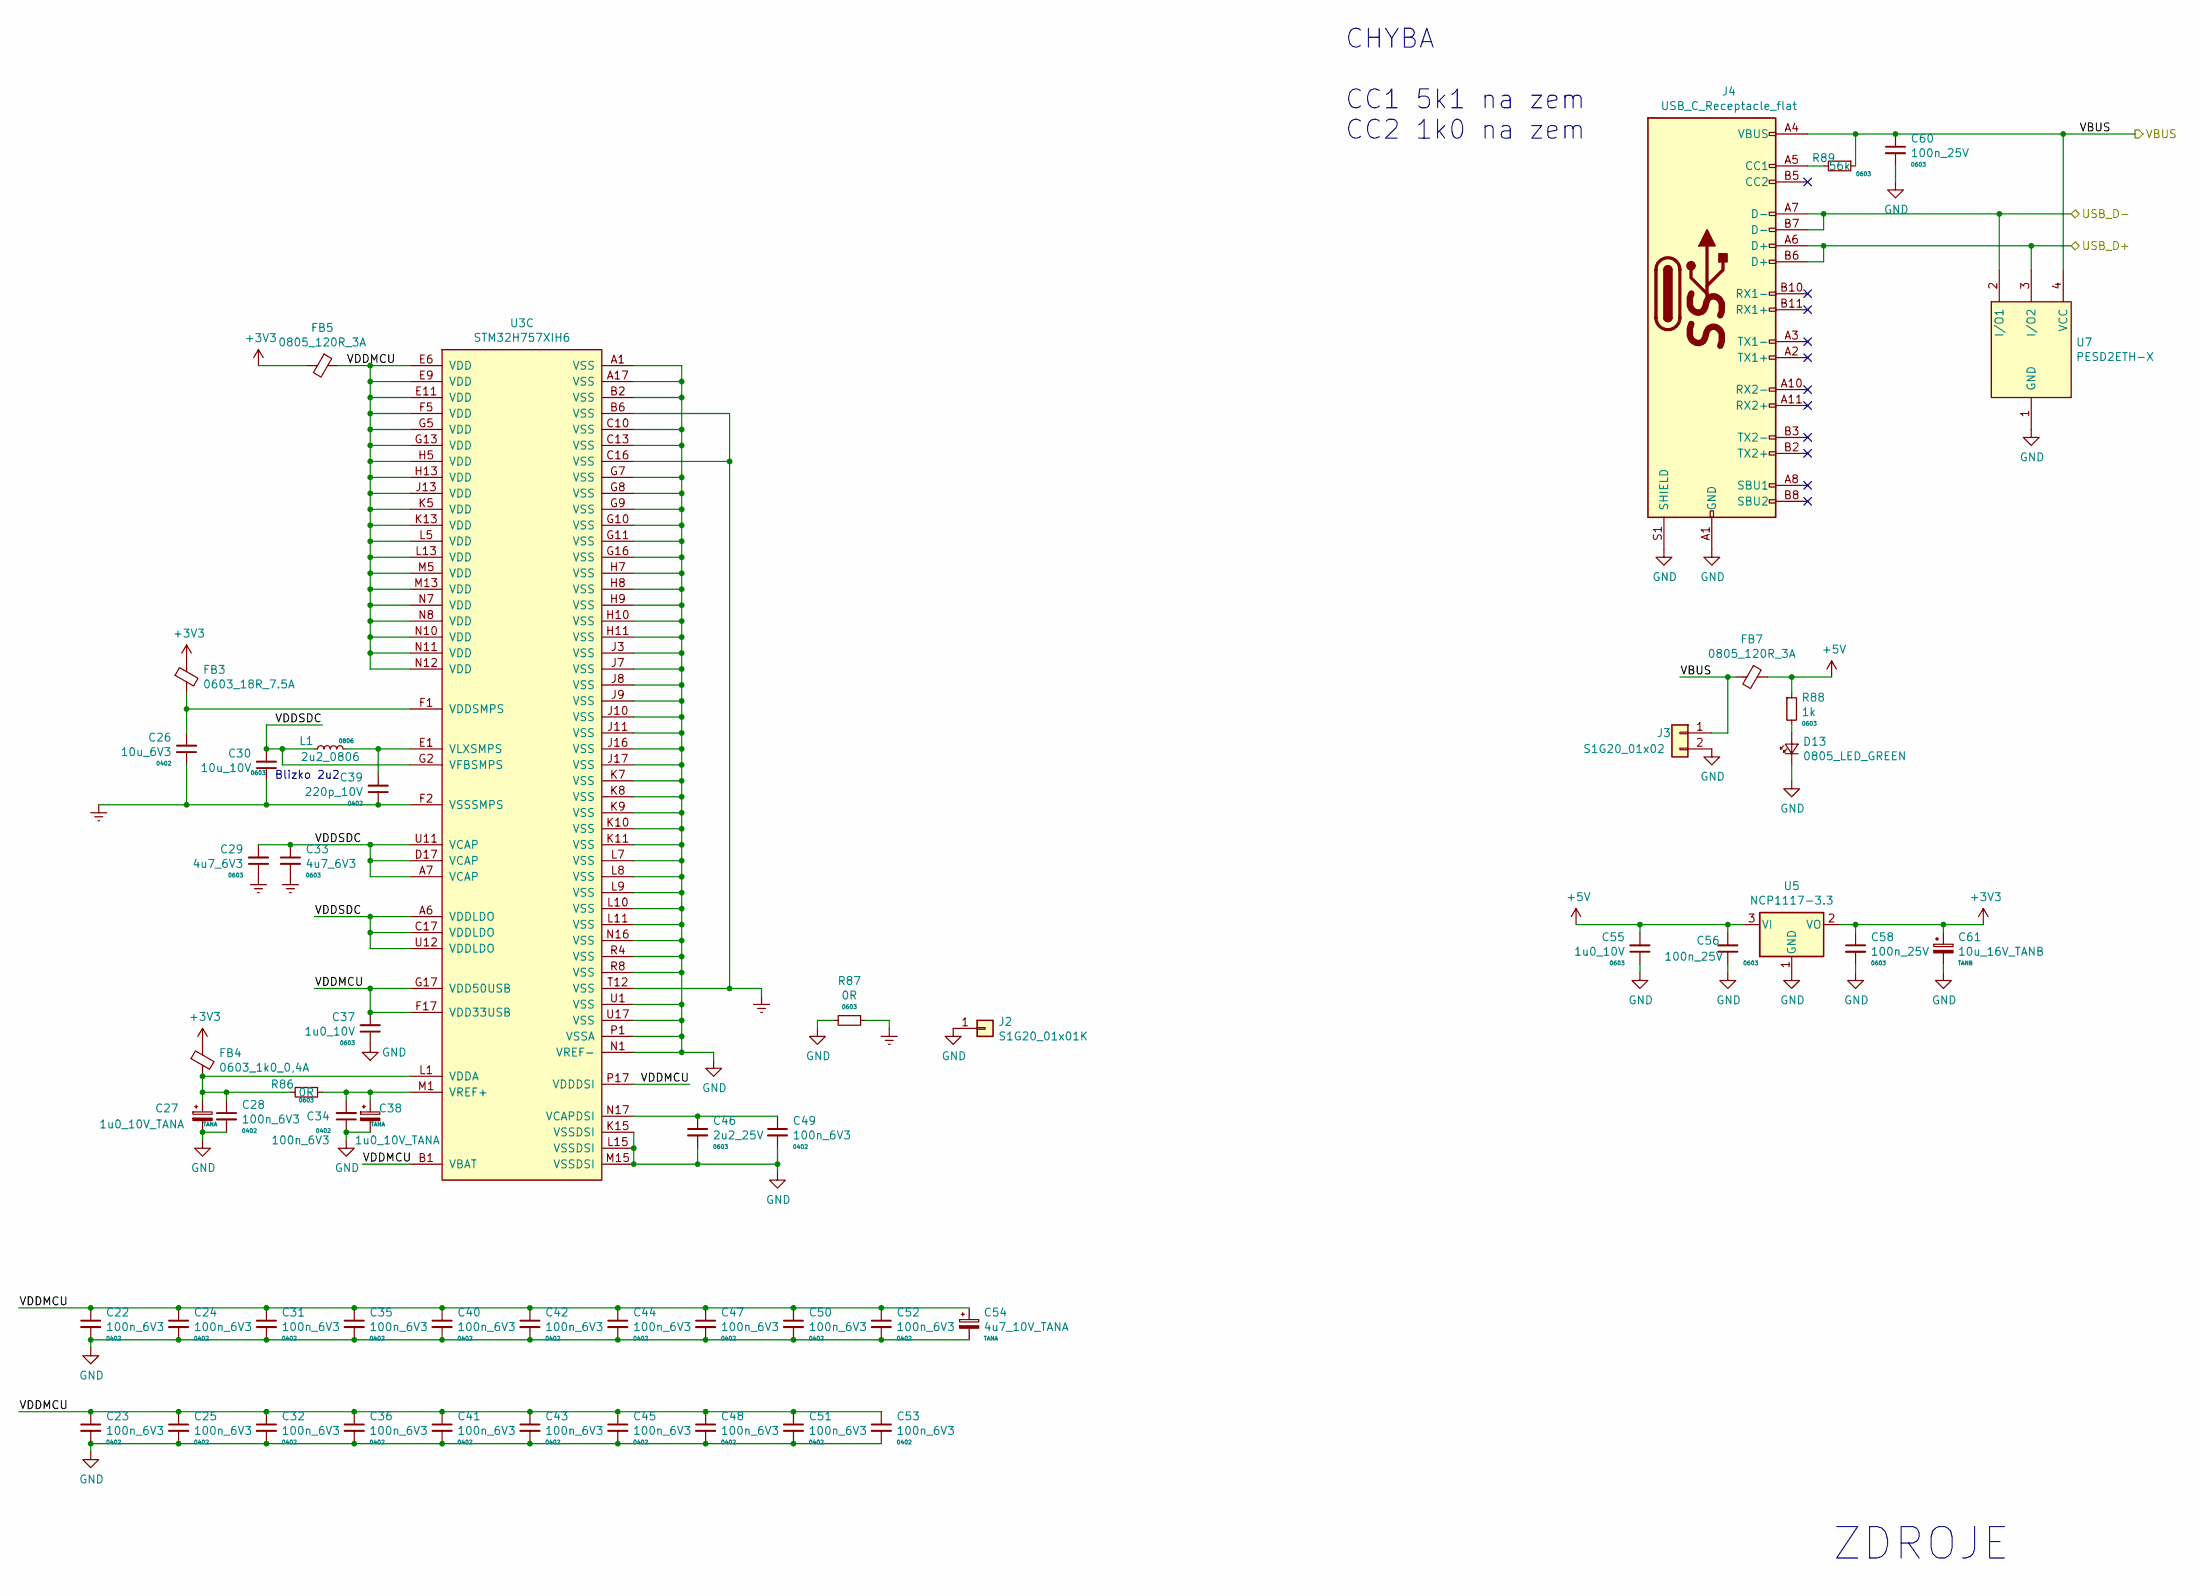
[picture p13: schematic MCUH7POWER.sch]

Parts:
C22, C23, C24, C25, C28, C31, C32, C34, C35, C36, C40, C41, C42, C43, C44, C45, C47, C48, C49, C50, C51, C52, C53: 100n_6V3; C_0402_1005Metric
C26: 10u_6V3; C_0402_1005Metric
C27, C38: 1u0_10V_TANA; CP_EIA-3216-18_Kemet-A
C29, C33: 4u7_6V3; C_0603_1608Metric
C30: 10u_10V; C_0603_1608Metric
C37, C55: 1u0_10V; C_0603_1608Metric
C39: 220p_10V; C_0402_1005Metric
C46: 2u2_25V; C_0603_1608Metric
C54: 4u7_10V_TANA; CP_EIA-3216-18_Kemet-A
C56, C58, C60: 100n_25V; C_0603_1608Metric
C61: 10u_16V_TANB; CP_EIA-3528-21_Kemet-B
D13: 0805_LED_GREEN; D_0805_2012Metric
FB3: 0603_18R_7.5A; R_0603_1608Metric
FB4: 0603_1k0_0,4A; R_0603_1608Metric
FB5, FB7: 0805_120R_3A; R_0805_2012Metric
J2: S1G20_01x01K; S1G20_1x1_kulaty
J3: S1G20_01x02; PinHeader_1x02_P2.54mm_Vertical
J4: USB_C_Receptacle_flat; USB-C_632723100011_1MM
L1: 2u2_0806; R_0805_2012Metric_Pad1.15x1.40mm_HandSolder
R86, R87: 0R; R_0603_1608Metric
R88: 1k; R_0603_1608Metric
R89: 56k; R_0603_1608Metric
U3: STM32H757XIH6; TFBGA-265_14x14mm_Layout17x17_P0.8mm
U5: NCP1117-3.3; SOT-223-3_TabPin2
U7: PESD2ETH-X; SOT-143

Connections:
+3V3: C58.1, C61.1, FB3.1, FB4.1, FB5.2, U5.2 (VO); also elsewhere on the board
+5V: C55.2, C56.2, FB7.1, R88.1, U5.3 (VI); also elsewhere on the board
/MCU Power/VDDMCU: C22.1, C23.1, C24.1, C25.1, C31.1, C32.1, C35.1, C36.1, C37.2, C40.1, C41.1, C42.1, C43.1, C44.1, C45.1, C47.1, C48.1, C50.1, C51.1, C52.1, C53.1, C54.1, FB5.1, U3.B1 (VBAT), U3.E6 (VDD), U3.E9 (VDD), U3.E11 (VDD), U3.F5 (VDD), U3.F17 (VDD33USB), U3.G5 (VDD), U3.G13 (VDD), U3.G17 (VDD50USB), U3.H5 (VDD), U3.H13 (VDD), U3.J13 (VDD), U3.K5 (VDD), U3.K13 (VDD), U3.L5 (VDD), U3.L13 (VDD), U3.M5 (VDD), U3.M13 (VDD), U3.N7 (VDD), U3.N8 (VDD), U3.N10 (VDD), U3.N11 (VDD), U3.N12 (VDD), U3.P17 (VDDDSI)
/MCU Power/VDDSDC: C29.2, C30.2, C33.1, L1.1, U3.A6 (VDDLDO), U3.A7 (VCAP), U3.C17 (VDDLDO), U3.D17 (VCAP), U3.G2 (VFBSMPS), U3.U11 (VCAP), U3.U12 (VDDLDO)
/USB_D+: J4.A6 (D+), J4.B6 (D+), U7.3 (I/O2); also elsewhere on the board
/USB_D-: J4.A7 (D-), J4.B7 (D-), U7.2 (I/O1); also elsewhere on the board
/VBUS: C60.1, FB7.2, J3.1, J4.A4 (VBUS), J4.A9 (VBUS), J4.B4 (VBUS), J4.B9 (VBUS), R89.1, U7.4 (VCC); also elsewhere on the board
Earth: C26.1, C29.1, C30.1, C33.2, C39.1, R87.1, U3.B6 (VSS), U3.C16 (VSS), U3.F2 (VSSSMPS), U3.T12 (VSS)
GND: C22.2, C23.2, C24.2, C25.2, C27.2, C28.2, C31.2, C32.2, C34.1, C35.2, C36.2, C37.1, C38.2, C40.2, C41.2, C42.2, C43.2, C44.2, C45.2, C46.2, C47.2, C48.2, C49.2, C50.2, C51.2, C52.2, C53.2, C54.2, C55.1, C56.1, C58.2, C60.2, C61.2, D13.1 (K), J2.1, J3.2, J4.A1 (GND), J4.A12 (GND), J4.B1 (GND), J4.B12 (GND), J4.S1 (SHIELD), R87.2, U3.A1 (VSS), U3.A17 (VSS), U3.B2 (VSS), U3.C10 (VSS), U3.C13 (VSS), U3.G7 (VSS), U3.G8 (VSS), U3.G9 (VSS), U3.G10 (VSS), U3.G11 (VSS), U3.G16 (VSS), U3.H7 (VSS), U3.H8 (VSS), U3.H9 (VSS), U3.H10 (VSS), U3.H11 (VSS), U3.J3 (VSS), U3.J7 (VSS), U3.J8 (VSS), U3.J9 (VSS), U3.J10 (VSS), U3.J11 (VSS), U3.J16 (VSS), U3.J17 (VSS), U3.K7 (VSS), U3.K8 (VSS), U3.K9 (VSS), U3.K10 (VSS), U3.K11 (VSS), U3.K15 (VSSDSI), U3.L7 (VSS), U3.L8 (VSS), U3.L9 (VSS), U3.L10 (VSS), U3.L11 (VSS), U3.L15 (VSSDSI), U3.M15 (VSSDSI), U3.N1 (VREF-), U3.N16 (VSS), U3.P1 (VSSA), U3.R4 (VSS), U3.R8 (VSS), U3.U1 (VSS), U3.U17 (VSS), U5.1 (GND), U7.1 (GND); also elsewhere on the board
unnamed: C26.2, FB3.2, U3.F1 (VDDSMPS)
unnamed: C27.1, C28.1, FB4.2, R86.2, U3.L1 (VDDA)
unnamed: C34.2, C38.1, R86.1, U3.M1 (VREF+)
unnamed: C39.2, L1.2, U3.E1 (VLXSMPS)
unnamed: C46.1, C49.1, U3.N17 (VCAPDSI)
unnamed: D13.2 (A), R88.2
unnamed: J4.A5 (CC1), R89.2

Notes on the sheet:
Blizko 2u2
ZDROJE
CHYBA CC1 5k1 na zem CC2 1k0 na zem
