hwidvorakinfo/BeastH7_v1/BEASTH7_01.kicad_pcb

## KiCad design BEASTH7_01.kicad_pcb (continued)

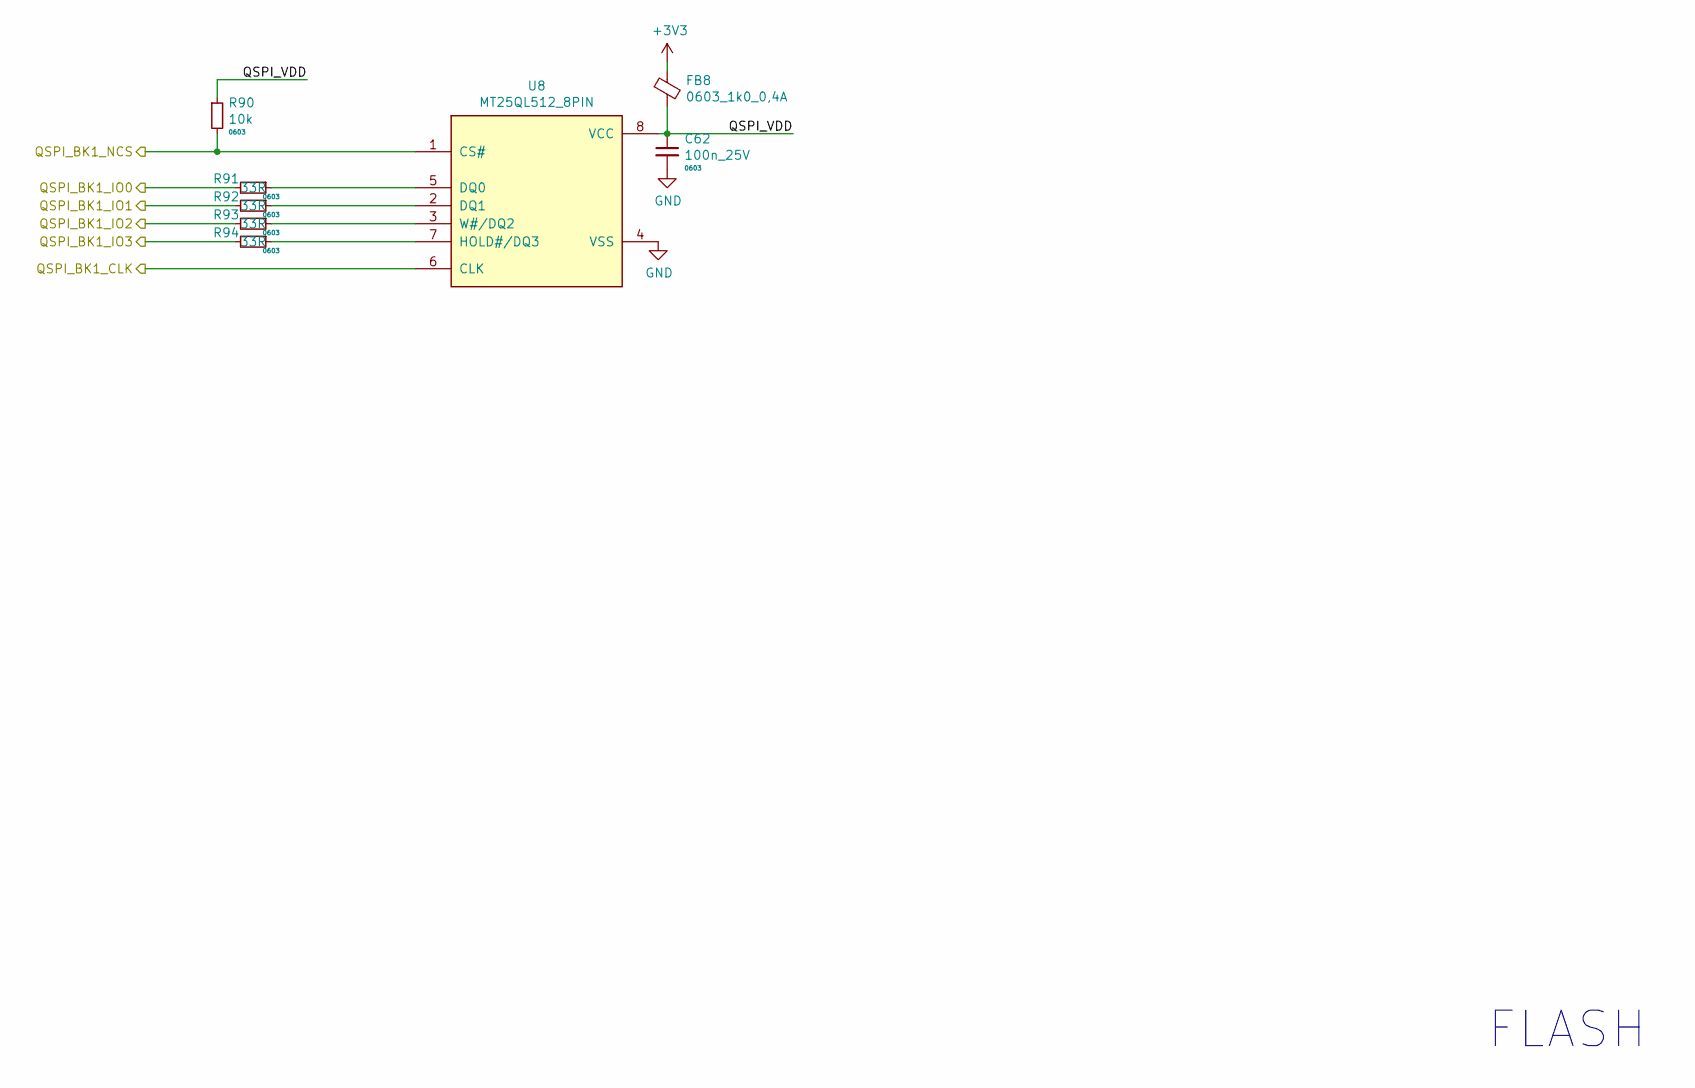
[picture p14: schematic QSPI_FLASH.sch]

Parts:
C62: 100n_25V; C_0603_1608Metric
FB8: 0603_1k0_0,4A; R_0603_1608Metric
R90: 10k; R_0603_1608Metric
R91, R92, R93, R94: 33R; R_0603_1608Metric
U8: MT25QL512_8PIN; W-PDFN-8_8x6MM

Connections:
+3V3: FB8.1; also elsewhere on the board
/MCU/QSPI_BK1_CLK: U8.6 (CLK); also elsewhere on the board
/MCU/QSPI_BK1_IO0: R91.2; also elsewhere on the board
/MCU/QSPI_BK1_IO1: R92.2; also elsewhere on the board
/MCU/QSPI_BK1_IO2: R93.2; also elsewhere on the board
/MCU/QSPI_BK1_IO3: R94.2; also elsewhere on the board
/MCU/QSPI_BK1_NCS: R90.2, U8.1 (CS#); also elsewhere on the board
/QSPI FLASH/QSPI_VDD: C62.1, FB8.2, R90.1, U8.8 (VCC)
GND: C62.2, U8.4 (VSS); also elsewhere on the board
unnamed: R91.1, U8.5 (DQ0)
unnamed: R92.1, U8.2 (DQ1)
unnamed: R93.1, U8.3 (W#/DQ2)
unnamed: R94.1, U8.7 (HOLD#/DQ3)

Notes on the sheet:
FLASH

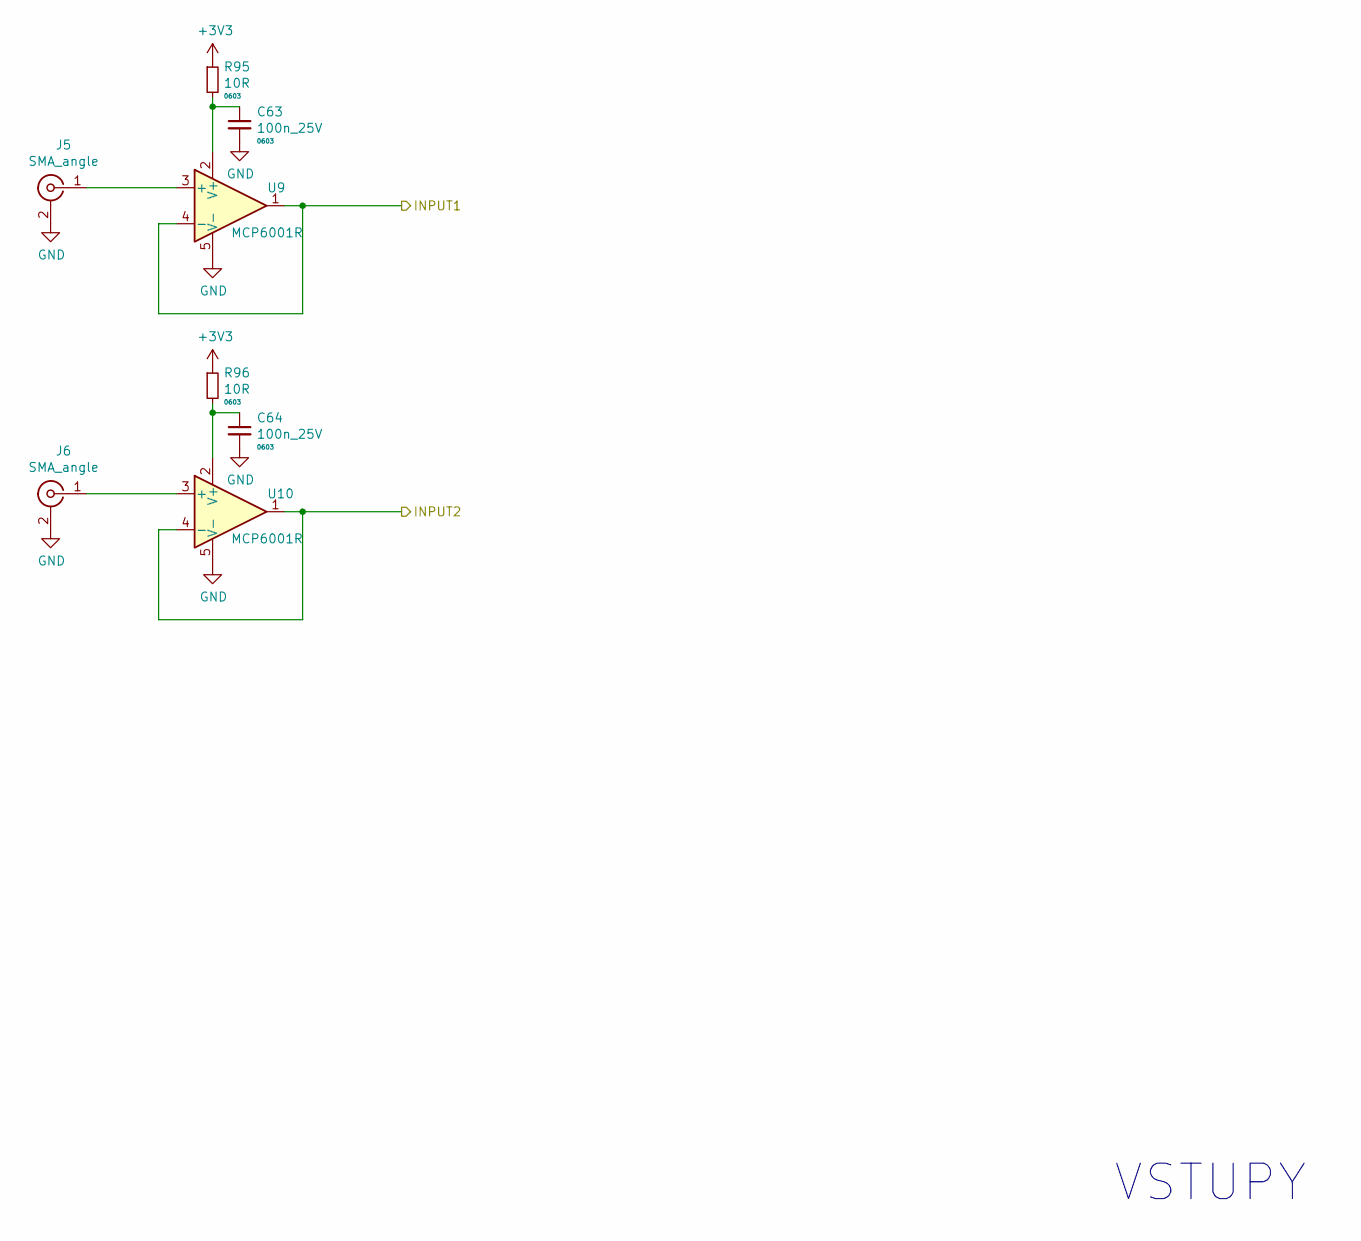
[picture p15: schematic ANALOG.sch]

Parts:
C63, C64: 100n_25V; C_0603_1608Metric
J5, J6: SMA_angle; SMA_Molex_73251-2200_Horizontal
R95, R96: 10R; R_0603_1608Metric
U9, U10: MCP6001R; SOT-23-5

Connections:
+3V3: R95.1, R96.1; also elsewhere on the board
/ADC Vstupy/INPUT1: U9.1, U9.4 (-); also elsewhere on the board
/ADC Vstupy/INPUT2: U10.1, U10.4 (-); also elsewhere on the board
GND: C63.2, C64.2, J5.2 (Ext), J6.2 (Ext), U9.5 (V-), U10.5 (V-); also elsewhere on the board
unnamed: C63.1, R95.2, U9.2 (V+)
unnamed: C64.1, R96.2, U10.2 (V+)
unnamed: J5.1 (In), U9.3 (+)
unnamed: J6.1 (In), U10.3 (+)

Notes on the sheet:
VSTUPY

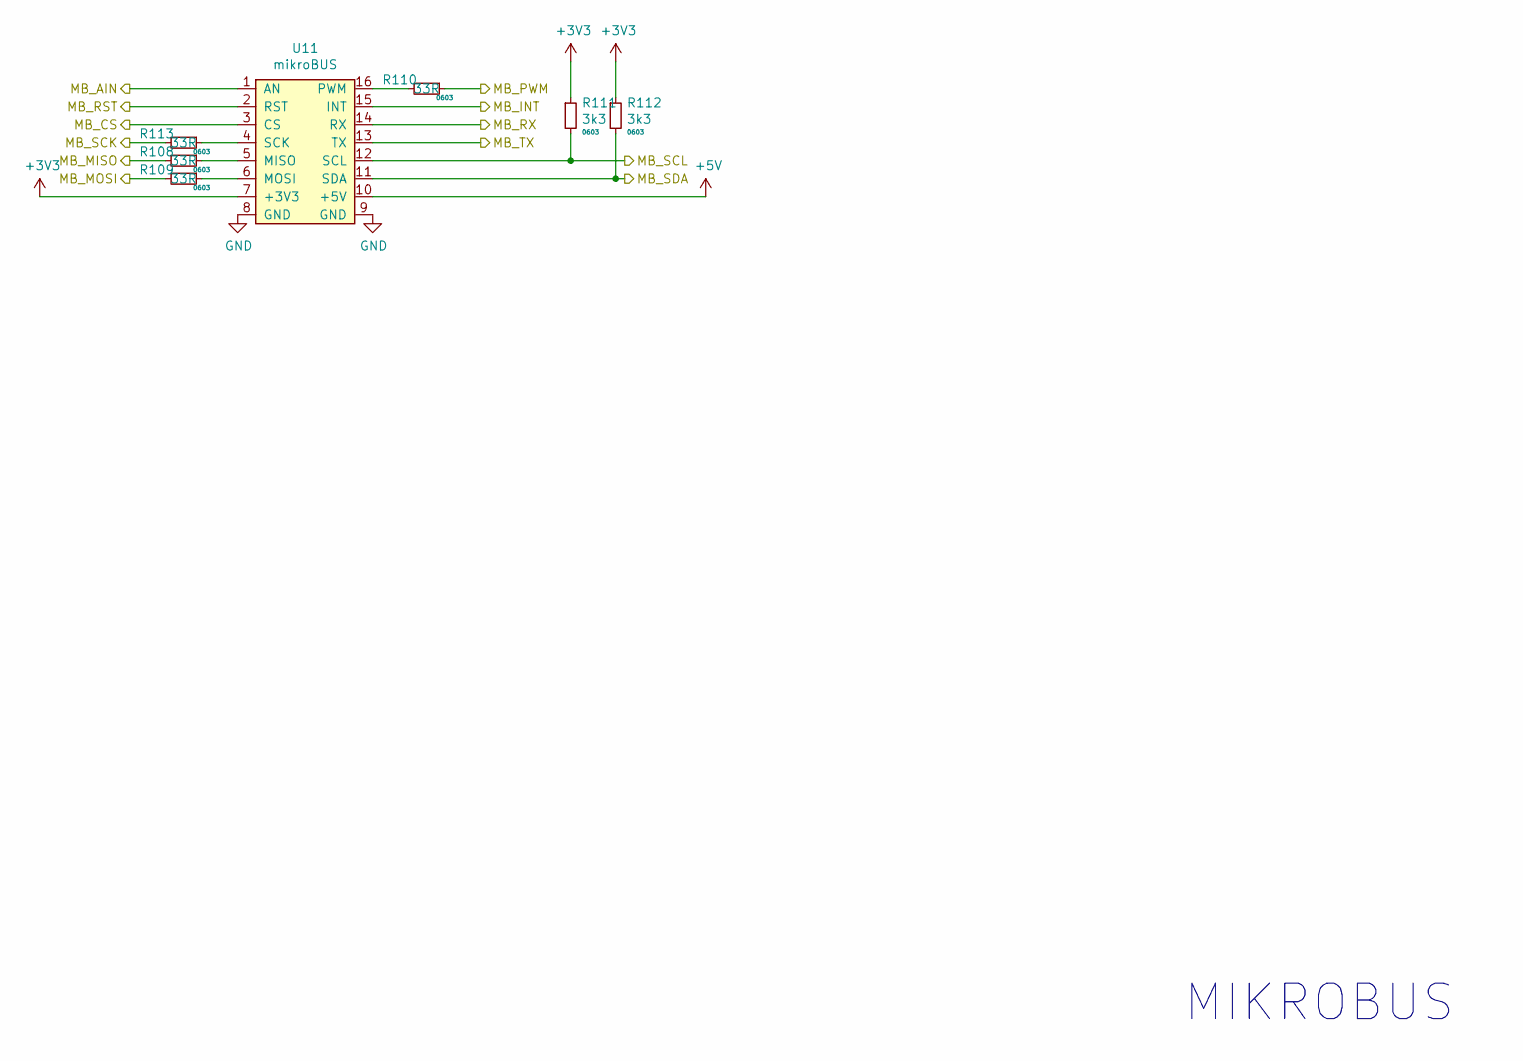
[picture p16: schematic MBUS.sch]

Parts:
R108, R109, R110, R113: 33R; R_0603_1608Metric
R111, R112: 3k3; R_0603_1608Metric
U11: mikroBUS

Connections:
+3V3: R111.1, R112.1, U11.7 (+3V3); also elsewhere on the board
+5V: U11.10 (+5V); also elsewhere on the board
/MCU/INPUT3: U11.1 (AN); also elsewhere on the board
/MCU/MB_CS: U11.3 (CS); also elsewhere on the board
/MCU/MB_INT: U11.15 (INT); also elsewhere on the board
/MCU/MB_MISO: R108.2; also elsewhere on the board
/MCU/MB_MOSI: R109.2; also elsewhere on the board
/MCU/MB_PWM: R110.1; also elsewhere on the board
/MCU/MB_RST: U11.2 (RST); also elsewhere on the board
/MCU/MB_RX: U11.14 (RX); also elsewhere on the board
/MCU/MB_SCK: R113.2; also elsewhere on the board
/MCU/MB_SCL: R111.2, U11.12 (SCL); also elsewhere on the board
/MCU/MB_SDA: R112.2, U11.11 (SDA); also elsewhere on the board
/MCU/MB_TX: U11.13 (TX); also elsewhere on the board
GND: U11.8 (GND), U11.9 (GND); also elsewhere on the board
unnamed: R108.1, U11.5 (MISO)
unnamed: R109.1, U11.6 (MOSI)
unnamed: R110.2, U11.16 (PWM)
unnamed: R113.1, U11.4 (SCK)

Notes on the sheet:
MIKROBUS

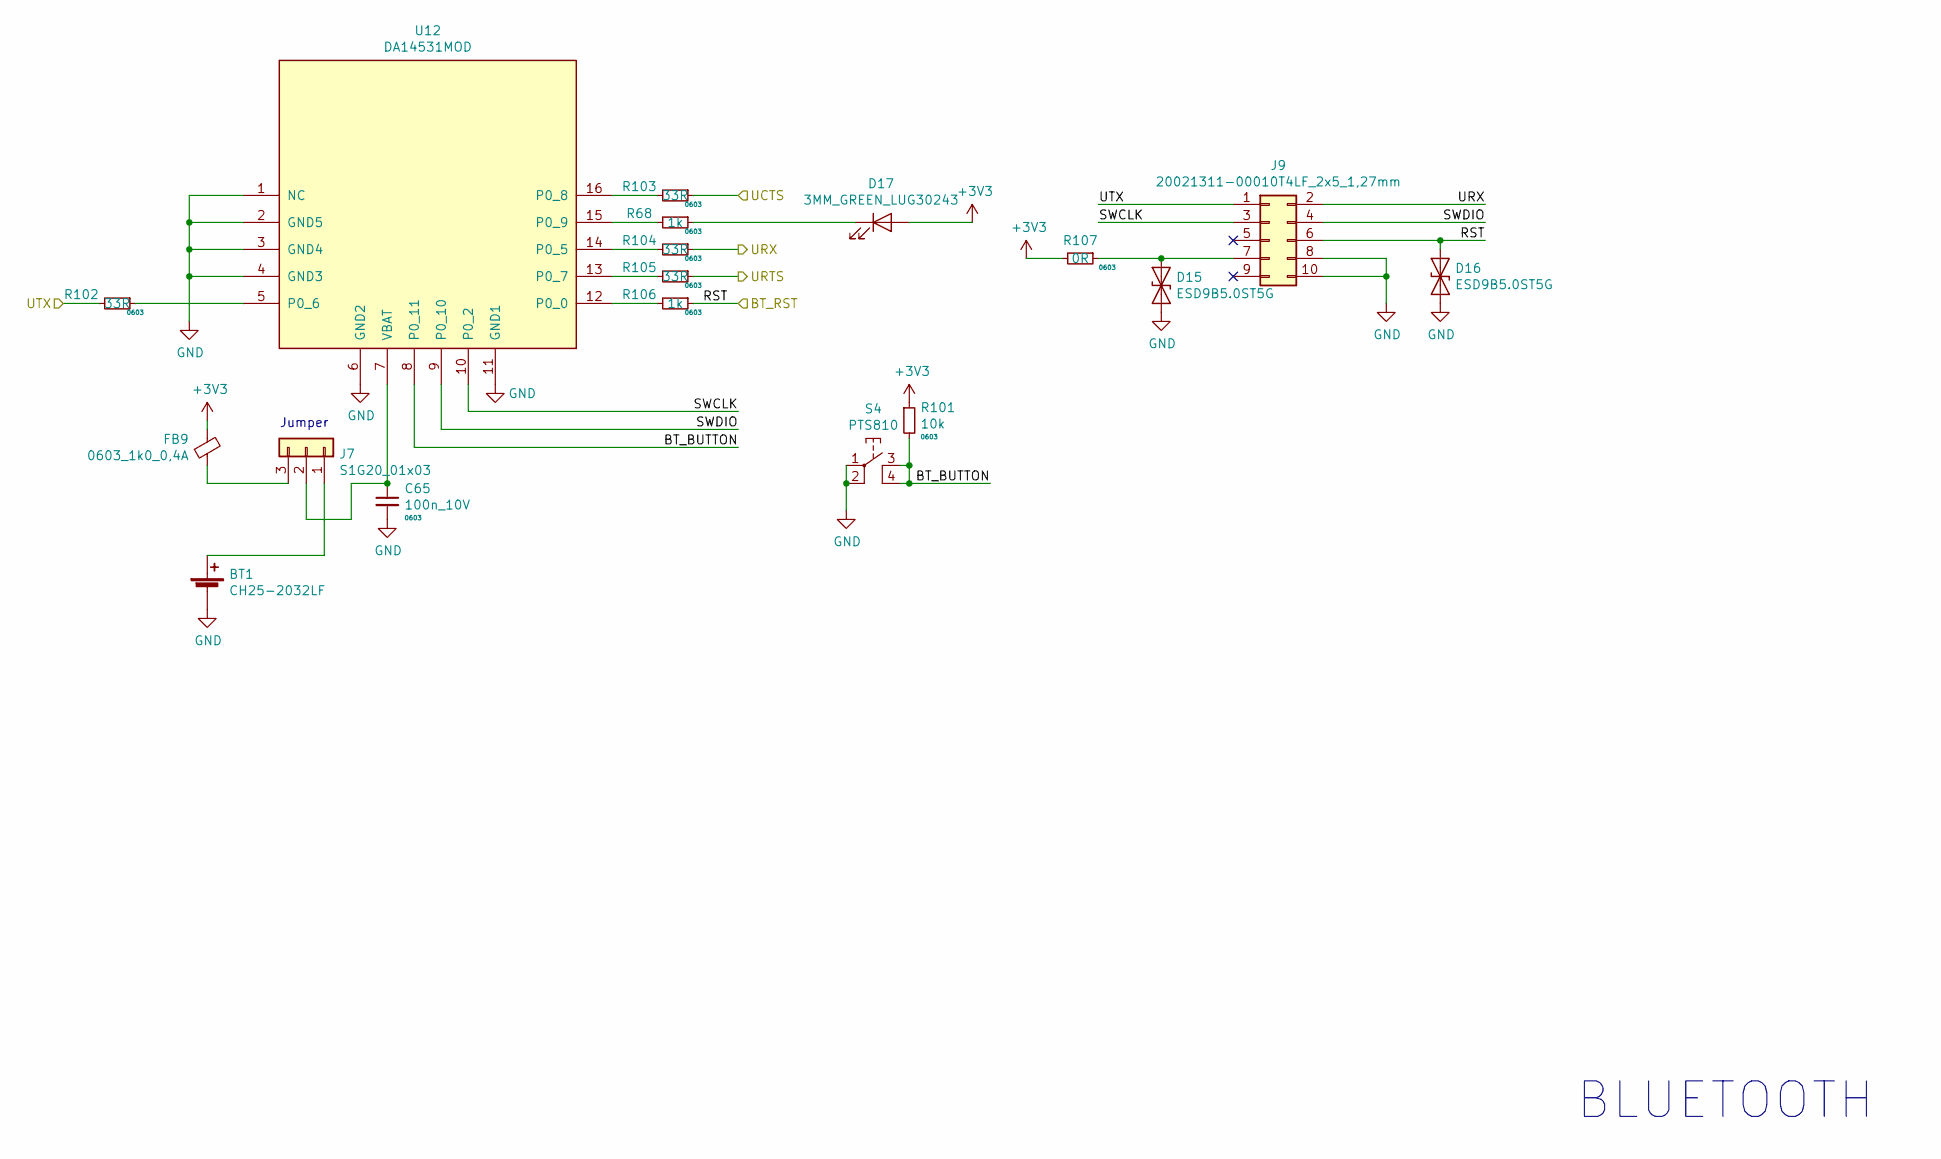
[picture p17: schematic BLUETOOTH.sch]

Parts:
BT1: CH25-2032LF
C65: 100n_10V; C_0603_1608Metric
D15, D16: ESD9B5.0ST5G; D_0402_1005Metric
D17: 3MM_GREEN_LUG30243; LED_D3.0mm
FB9: 0603_1k0_0,4A; R_0603_1608Metric
J7: S1G20_01x03; PinHeader_1x03_P2.54mm_Vertical
J9: 20021311-00010T4LF_2x5_1,27mm; PinHeader_2x05_P1.27mm_Vertical
R68, R106: 1k; R_0603_1608Metric
R101: 10k; R_0603_1608Metric
R102, R103, R104, R105: 33R; R_0603_1608Metric
R107: 0R; R_0603_1608Metric
S4: PTS810; MIKROSPINAC_PTS810
U12: DA14531MOD

Connections:
+3V3: D17.2 (A), FB9.2, R101.1, R107.2; also elsewhere on the board
/Bluetooth/BT_BUTTON: R101.2, S4.3, S4.4, U12.8 (P0_11)
/Bluetooth/BT_RST: D16.1 (A1), J9.6, R106.1; also elsewhere on the board
/Bluetooth/SWCLK: J9.3, U12.10 (P0_2)
/Bluetooth/SWDIO: J9.4, U12.9 (P0_10)
/USB-UART/CTS: R103.1; also elsewhere on the board
/USB-UART/RTS: R105.1; also elsewhere on the board
/USB-UART/RXD: J9.2, R104.1; also elsewhere on the board
/USB-UART/TXD: J9.1, R102.2; also elsewhere on the board
GND: BT1.2 (-), C65.2, D15.2 (A2), D16.2 (A2), J9.8, J9.10, S4.1, S4.2, U12.1 (NC), U12.2 (GND5), U12.3 (GND4), U12.4 (GND3), U12.6 (GND2), U12.11 (GND1); also elsewhere on the board
unnamed: BT1.1 (+), J7.1
unnamed: C65.1, J7.2, U12.7 (VBAT)
unnamed: D15.1 (A1), J9.7, R107.1
unnamed: D17.1 (K), R68.1
unnamed: FB9.1, J7.3
unnamed: R68.2, U12.15 (P0_9)
unnamed: R102.1, U12.5 (P0_6)
unnamed: R103.2, U12.16 (P0_8)
unnamed: R104.2, U12.14 (P0_5)
unnamed: R105.2, U12.13 (P0_7)
unnamed: R106.2, U12.12 (P0_0)

Notes on the sheet:
BLUETOOTH
Jumper

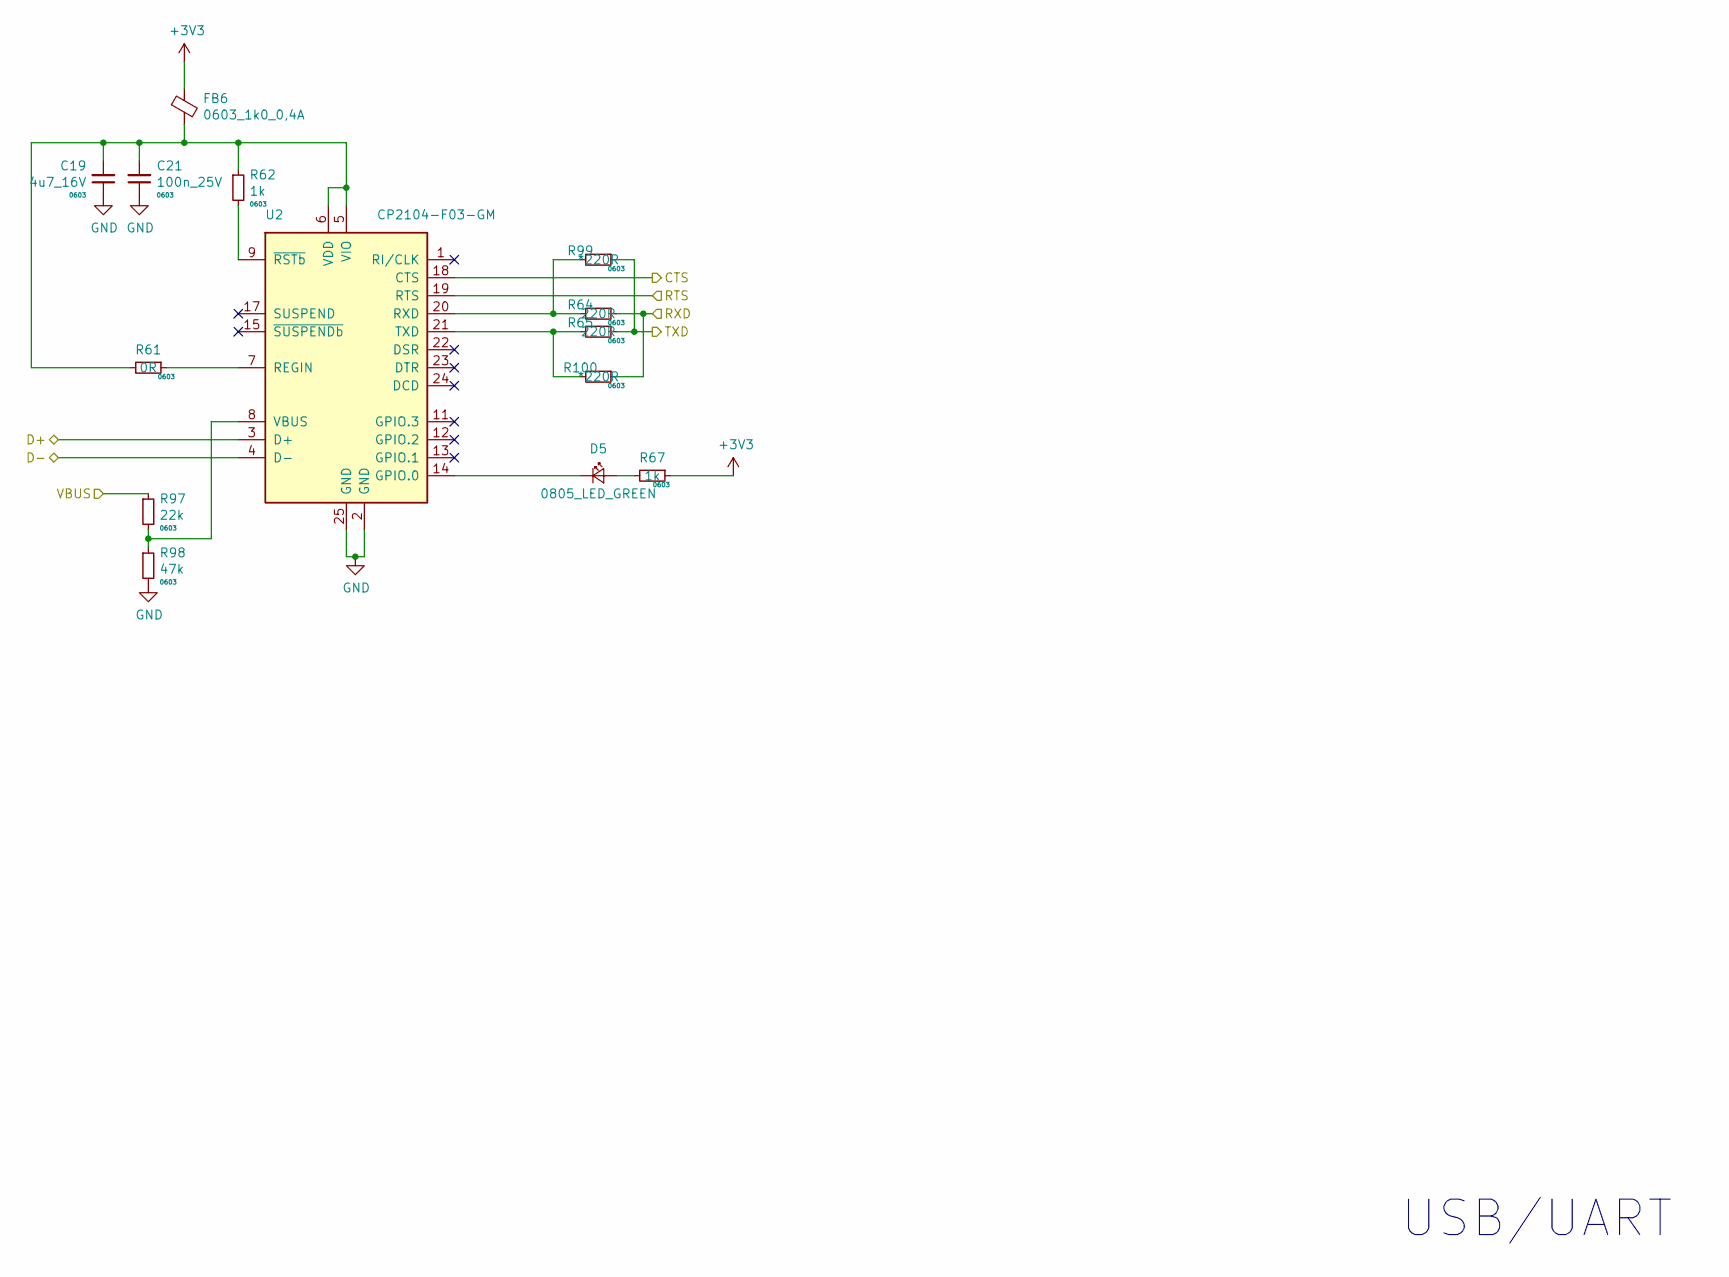
[picture p18: schematic USB2UART.sch]

Parts:
C19: 4u7_16V; C_0603_1608Metric
C21: 100n_25V; C_0603_1608Metric
D5: 0805_LED_GREEN; D_0805_2012Metric
FB6: 0603_1k0_0,4A; R_0603_1608Metric
R61: 0R; R_0603_1608Metric
R62, R67: 1k; R_0603_1608Metric
R64, R65: 220R; R_0603_1608Metric
R97: 22k; R_0603_1608Metric
R98: 47k; R_0603_1608Metric
R99, R100: *220R; R_0603_1608Metric
U2: CP2104-F03-GM; QFN-24-1EP_4x4mm_P0.5mm_EP2.6x2.6mm

Connections:
+3V3: FB6.1, R67.1; also elsewhere on the board
/USB-UART/CTS: U2.18 (CTS); also elsewhere on the board
/USB-UART/RTS: U2.19 (RTS); also elsewhere on the board
/USB-UART/RXD: R64.1, R100.1; also elsewhere on the board
/USB-UART/TXD: R65.1, R99.1; also elsewhere on the board
/USB_D+: U2.3 (D+); also elsewhere on the board
/USB_D-: U2.4 (D-); also elsewhere on the board
/VBUS: R97.1; also elsewhere on the board
GND: C19.1, C21.1, R98.2, U2.2 (GND), U2.25 (GND); also elsewhere on the board
unnamed: C19.2, C21.2, FB6.2, R61.2, R62.1, U2.5 (VIO), U2.6 (VDD)
unnamed: D5.1 (K), U2.14 (GPIO.0)
unnamed: D5.2 (A), R67.2
unnamed: R61.1, U2.7 (REGIN)
unnamed: R62.2, U2.9 (~RSTb)
unnamed: R64.2, R99.2, U2.20 (RXD)
unnamed: R97.2, R98.1, U2.8 (VBUS)
unnamed: R65.2, R100.2, U2.21 (TXD)

Notes on the sheet:
USB/UART

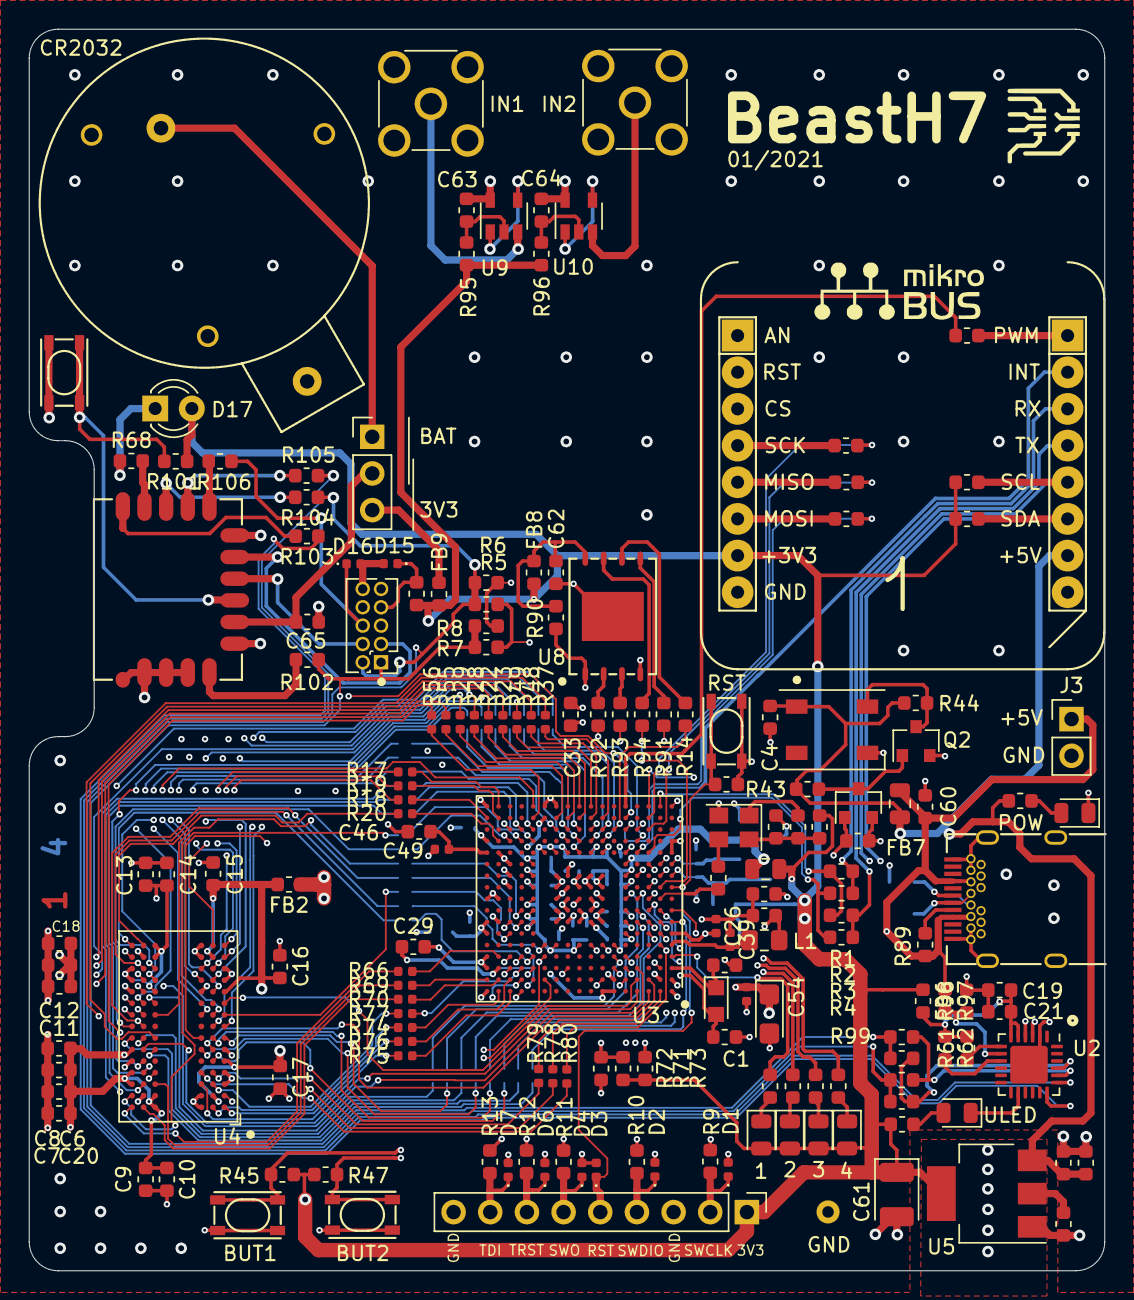
[picture p19: board BEASTH7_01.kicad_pcb from above]

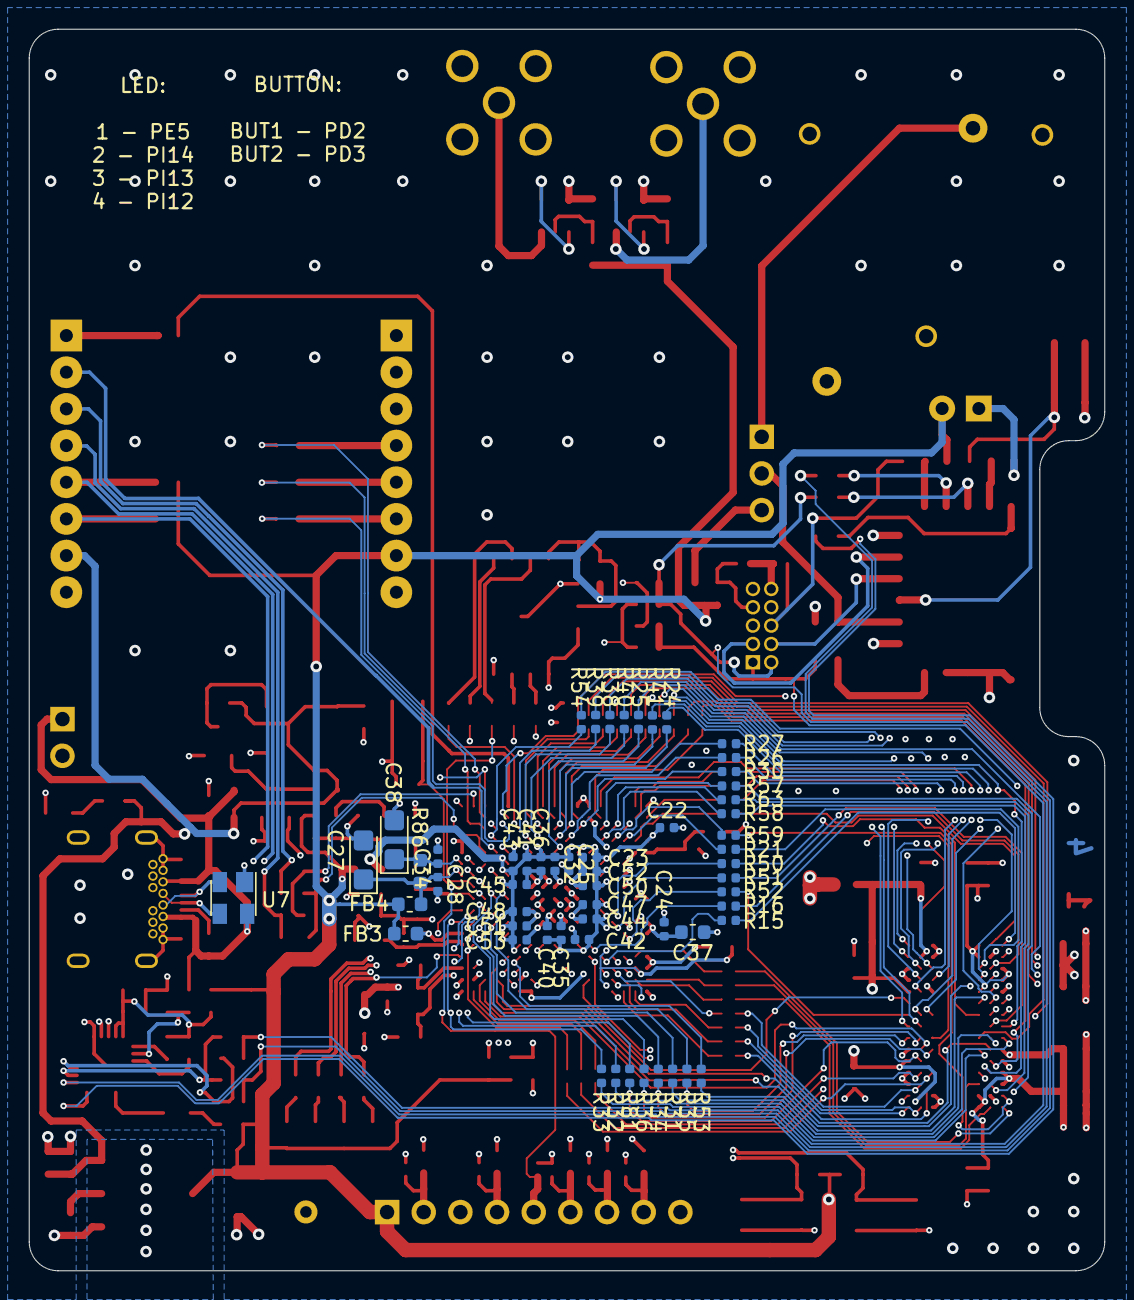
[picture p20: board BEASTH7_01.kicad_pcb from below]

Board: 4 copper layers, 74.5 x 86.0 mm, 230 parts (56 on the bottom side), 221 nets.
